ernerdl/smart-knob/docs/tartisma.md

# SmartKnob — sıkıntıların kökü üzerine tartışma

## Uzman A — açılış argümanı

### Tez

SmartKnob'un sorunlarının ezici çoğunluğu **fizikten veya bileşen sınırlarından değil, miras alınmış varsayılan değerlerden ve bayatlamış varsayımlardan** geliyor. Ve her seferinde ilk teşhis, en *ilginç* sebebi (EMI, döngü hızı, sürücü kalitesi, sensör gürültüsü) suçlayıp en *sıradan* olanı (bir vida, kimsenin dönüp bakmadığı bir sabit, yalan söyleyen bir yorum satırı) atladı.

### Kanıt — sadece bugünden

| belirti | ilk teşhis | ölçümle çıkan gerçek |
|---|---|---|
| HS 7 günde 824 MB | `sendLine` süreç açıyor | `brLevel()` 2 sn'de bir `ioreg` → günde 43.200 süreç × 2.4 KB ≈ **726 MB**. Asıl kaynak raporda hiç geçmiyordu |
| Aynı sızıntı | `mouseMoved` eventtap | Ölçüldü: 13.425 olay / 60 sn = **0.03 MB**. Masum |
| "Knob hangi taraftaysa oraya dayanıyor" | kalibrasyon / sürücü | `float maxA = 1.0f` — iskelet koddan kalma varsayılan |
| Konumlandırma 3.04° ıskalıyor | sürtünme 4–5 kat yüksek | `Kcenter = 6`, başka bir özellikten miras. 22 yapınca **0.09°** |
| Duvarlar esneyerek ölçülmüş olabilir | hipotez | Elle ölçüm: fark **0.1–0.2°**. Elendi |
| Çentik konumlandırmayla savaşıyor | benim teşhisim | Kod zaten `if/else` ile ayırıyormuş. **Yanlıştı** |

Tarihçede de aynı desen: "kesin EMI" → braket vidaları pedlere değiyormuş. "Sürücü kötü" → L298N'in kayıpları aslında sönüm sağlıyormuş. "Çentik zayıf, sertliği artır" → güç aralıktan geliyormuş, sertlik sadece kararsızlık üretiyormuş.

### Karşı tarafın muhtemel tezi ve ona cevabım

"Asıl sorun mimari: akım döngüsü yok, voltaj modu her şeyi sınırlıyor."

Kısmen doğru ama **öncelik sıralaması olarak yanlış.** Voltaj modu gerçek bir tavan koyuyor — sıfır hata matematiksel olarak imkânsız, her zaman `sürtünme ÷ sertlik` kadar ölü bölge kalıyor. Ama bugün ölçtük: o tavan **0.05°** civarında. Oysa sistem **3.04°** hata veriyordu. Yani gerçek sınır, yaşadığımız sorunun **altmışta biri**. Mimariyi suçlamak, 60 kat payı olan şeyi görmezden gelmek olur.

### Fiziğin gerçekten konuştuğu tek yer

Dürüst olmak için: sol duvarda integral **tavana dayanıyor** (2.5 V) ve 0.09–0.12°'de kalıyor. Orası gerçek bir sınır. Ama bu, ulaşılabilir hedeflerin %99'unu etkilemiyor.

### Pratik sonuç — açık sorunların zarar sıralaması

1. **EN pini 3.3V'a sabit.** Tek fiziksel hasar veren sorun: 2 gün motor sürülmüş, braket erimiş, LED'ler ölmüş. Bugün bootloader'da yine titredi. Bu **ölçüm disipliniyle çözülmez**, donanım işi. Ve listedeki tek "gerçek" sorun bu.
2. **Aralıklı adım sayımı arızası.** 2 vaka, sebep bilinmiyor, teşhis araçları hazır ama tekrarlamadı.
3. Uçtan uca test hiç yapılmadı.
4. Akım ölçümü (INA240 alındı, kurulmadı) — ölçüm aracı olarak değerli, ama yukarıdakilerin hiçbirini çözmez.

### Savunduğum ilke

Bu projenin en yüksek getirili aracı pahalı donanım değil, **evet/hayır cevabı zorlayan ucuz ölçüm** oldu. MT6701'in CRC sayacı bedava bir EMI dedektörü verdi (577M okuma, 0 hata — EMI tartışması tek komutla kapandı). Tam döngü hızındaki burst kaydedici teşhisi saatlerden saniyelere indirdi. Bugün duvar hipotezini 2 dakikalık elle ölçüm çürüttü.

Buna karşılık, ölçmeden yürütülen her teori yanlış çıktı — benimkiler dahil.

---

### (Dar konu: mutlak konumlandırma)

## Ortak zemin (ölçülen veriler)

Sistem: ESP32-S3 + SimpleFOC 2.3.3, GBM2805 (7 kutup çifti, faz-faz 5.51 Ω, 140 KV),
MT6701 14-bit SSI, L6234PD, 20 kHz PWM, **voltaj modu tork kontrolü (akım döngüsü YOK)**,
FOC ~7.7 kHz, `voltage_limit = 5 V`. Fiziksel aralık 319.6°, duvarlar 6.7° ve 326.3°.

Kontrolcü:
- Yol fazı (hata > 3°): `t = -6.0·e - 0.35·v`        (Kcenter = 6 V/rad)
- Tutma fazı (hata < 3° ve |v| < 1): `t = -22·e - 0.05·v - I`, `I += 100·e·dt`, |I| ≤ 1.5 V
- Varış: 0.05° içinde 50 ms. Zaman aşımı: 3 s (gidiş süresi dahil).

Ölçüm:

| hedef | devirdeki hata | integral | sonuç |
|---|---|---|---|
| 10° / 20° / 50° / 180° | 0.027–0.044° | 0.02–0.24 V | oturdu |
| 6.7° (sol duvar) | +0.133° | 0.90 V | zaman aşımı |
| 326.3° (sağ duvar) | −3.038° | 0.00 V | zaman aşımı |

Kısıtlar: akım ölçümü yok, osiloskop yok. `Kdet = 44` kararsızdı; sönüm artırmak çırpıntıyı
artırıyor (gecikmeli hız tahmini sönümü sertliğe çeviriyor).

---

## Uzman B — açılış argümanı (aynı anda yazıldı, A'nın açılışını görmeden)

### 1. Kök sebep: voltaj modunda takılma hatası = sürtünme ÷ sertlik

Akım döngüsü olmadığı için tork doğrudan komut edilen voltajdır. Knob, komut edilen voltaj
yerel sürtünmeyi yenemediği noktada durur. Denge şartı `K·e = V_sürtünme`, yani:

```
e_takılma = V_sürtünme / K
```

Sağ duvarda ölçülen: `6.0 × 0.05303 rad = 0.318 V` komutla durmuş. Yani oradaki sürtünme
≈ 0.32 V. Aynı sürtünme altında K = 22 olsaydı hata **0.83°** olurdu.

### 2. Asıl arıza bir kilitlenme, bir hassasiyet sorunu değil

Tutma fazının kapısı `|e| < 3.0°`, knob **3.038°**'de durmuş. İntegral (tek güçlü mekanizma)
kapının 0.038° dışında kaldığı için hiç devreye girmemiş. İntegrale ulaşmak için yaklaşmak,
yaklaşmak için integral gerekiyor.

Sol duvarda ise integral çalışmış ama hızı `100·e`, yani hata küçüldükçe yavaşlıyor:
0.133°'de **0.232 V/s**. 0.90 V'tan tavana (1.5 V) 2.6 s gerekiyordu, toplam bütçe 3 s ve
gidiş de buna dahil. Yani integral tavana dayanmadı, **süresi doldu**.

İki başarısızlık da kontrolcü yapısından geliyor; ikisi de fiziksel sınır değil.

### 3. Önerdiğim sıra

**(a) Önce homing esneklik testi (10 dk).** Duvar açıları `homingV = 4.5 V` ile bastırılarak
ölçüldü. `homingV = 1.5 V` ile yeniden homing yapılsın, iki ölçüm karşılaştırılsın. Fark
anlamlıysa duvar hedefleri **fiziksel olarak ulaşılamaz** demektir ve o iki vaka tartışma dışı
kalır. Bu test yapılmadan 1-2-3'e harcanan emek boşa gidebilir.

**(b) İki fazda aynı sertlik (K = 6 → 22), ama hız sınırıyla birlikte.**
Tek başına sertliği yükseltmek yetmez: 22 ile uzun yolda (176°) komut 5 V'a doyar, kararlı hız
`5/0.35 ≈ 14 rad/s` (800°/s) olur. Tutma fazına o hızla girildiğinde sönüm `0.05 × 14 = 0.7 V`,
yay ise `22 × 0.052 = 1.15 V` üretir → aşma ve salınım. Bu yüzden ya yol fazının sönümü 0.35'te
tutulmalı, ya da yaklaşmaya bir hız tavanı konmalı (ör. 3–4 rad/s).

**(c) İntegral: kapı mesafe değil hız olsun, ve bir taban hızı olsun.**
`|v| < 0.5 && |e| > POS_TOL` iken integre et; `posI += KI · max(|e|, e_taban) · sign(e) · dt`.
Küçük hatada sabit hızlı, büyük hatada orantılı. Sadece konumlandırma aktifken çalışsın
(kullanıcı knob'u tutarken birikip bırakınca fırlatmasın).

**(d) Kalıcı cevap: sürtünme ileri beslemesi.** Durur haldeyken komuta `sign(e)·V_kopma` ekle.
V_kopma, birkaç açıda yavaş voltaj rampasıyla ölçülür (burst kaydedici mevcut). Önemi:
**döngü kazancını artırmaz**, dolayısıyla `Kdet=44`'teki kararsızlığı geri getirmez.

### 4. Bundan bağımsız bir doğruluk hatası

```c
if (reached && absPos) { relAnchor = centerTarget; hapCenter = centerTarget; }
else relAnchor = motor.shaft_angle;     // zaman aşımında grid takılınan yere kayar
```
Konumlandırma mükemmel çalışsa bile, herhangi bir zaman aşımında "seviye ↔ açı" eşlemesi
sessizce bozulur. Konumlandırmayı düzeltmek bunu **gizler, çözmez**. Ayrıca düzeltilmeli.

### 5. Tartışmaya açtığım iddia

"Sertliği artırmak kararsızlık getirir" endişesinin bu bağlamda **geçersiz** olduğunu
savunuyorum. `Kdet = 44` ölçümündeki kararsızlığın kaynağı sertliğin kendisi değil, testere
profilinin sınırındaki **süreksizlikti**: sınırda tork `Kdet·sp` kadar (44 × 0.22 ≈ 9.7 V,
tavanın üstünde) sıçrıyor ve her sınır geçişi sisteme enerji enjekte ediyordu. Konumlandırma
yayı ise **tek kuyulu ve sürekli**; süreksizliği yok. Dolayısıyla K = 22'nin kararlı olduğu
zaten tutma fazında ölçülmüş durumda ve yol fazında da kararlı olmalıdır.

Karşı tarafın bu ayrımı çürütmesini ya da onaylamasını istiyorum: kararsızlığın kaynağı
süreksizlik mi, yoksa sertlik + hız tahmini gecikmesi mi?

### 6. Ayrışmayı bitirecek ölçülebilir tahminler

1. `homingV` 4.5 → 1.5 V: duvar açıları 1°'den fazla kayarsa → hipotez "duvar esnek" doğrulanır.
2. K = 22 ile orta bölgede takılma hatası ~0.06°, duvarda ~0.83° olmalı (sürtünme/sertlik).
3. Sürtünme ileri beslemesi eklenince hata, ileri besleme hatasının sertliğe bölümüne iner;
   V_kopma ±%20 doğrulukla ölçülürse hata < 0.2° olmalı.
4. K = 22 + mevcut sönüm (0.35) ile aşma olmamalı; sönüm 0.05'e indirilirse aşma görülmeli.

---

## Uzman B — 2. tur (A'nın açılışına cevap)

### Değerlendirme: nerede haklı

**Ölçüm disiplini tezi sağlam ve kanıtlı.** Altı vakanın altısında da "ilginç sebep" çürümüş.
Bu, tartışılacak bir şey değil, veri.

**Benim açılışımdaki iki maddeyi doğrudan çürüttü, kabul ediyorum:**

1. **Duvar esnekliği hipotezi.** Ben "önce bunu test edin, yoksa emek boşa gider" demiştim.
   A elle ölçmüş: fark **0.1–0.2°**. Hipotez eleniyor. Testin yapılması doğruydu, hipotezin
   ağırlığını fazla tahmin etmem yanlıştı.

2. **`e = V_sürtünme / K` modeliyle yaptığım tahmin yanlış çıktı.** K = 22 için **0.83°**
   öngörmüştüm, ölçülen **0.09°** — 9 kat sapma. Modelim neden şişti:
   - 0.318 V'u "oradaki sürtünme" saydım. Aslında o, **kilitlenmenin** ölçüsüydü: knob
     3.04°'de durdu çünkü yay zayıftı *ve* integral kapısı açılmadı. Sürtünmenin gerçek
     değeri bundan küçük, üst sınırını ölçmüştüm.
   - Statik denge modeli knob'un **hareket halinde** geldiğini yok sayıyor. Daha sert yayla
     gelen knob ölü bölgeyi kinetik enerjiyle geçiyor; denge noktası statik hesaptan dar.

   Bu, A'nın tezinin tam da örneği: ben de "fizik tavanı" diye sunduğum şeyi ölçmeden
   hesaplamıştım.

**Öncelik sıralaması da doğru.** EN pini listedeki tek **fiziksel hasar veren** sorun ve
yazılımla çözülemez. Birinci sırada olmalı.

### Nerede eksik: tezin kendi seçim yanlılığı

"Sorunların çoğu sıradan sebeplerden geliyor" iddiası **çözülmüş** vakalarla kanıtlanıyor.
Ama bir hata ancak sebebi bulunabildiğinde "çözülmüş" sayılıyor, ve ucuz ölçümle bulunabilen
sebepler tanımı gereği sıradan oluyor. Yani kanıt kümesi tezin lehine seçilmiş.

Testi şu: **açık kalan tek arıza** (aralıklı adım sayma, 2 vaka, tekrarlamıyor) bu yöntemin
yakalayamadığı sınıfta. Çünkü yöntem *tekrarlanabilir* belirtiye ihtiyaç duyuyor; bu arıza
tekrarlamıyor.

**Önerim — kara kutu:** Burst kaydedici zaten var ama elle tetikleniyor. Sürekli dönen bir
halka tampona çevrilsin (son ~2 sn: açı, hız, tork, adım olayları, HID gönderimleri, zaman
damgaları), ve **arıza imzası** tetiklesin (ör. adım tetiklendi ama HID gönderilmedi; ya da
iki adım arası < 20 ms). Arıza olduğunda otomatik dökülsün. Böylece tekrarlanamayan arıza
bir sonraki olduğunda **bir kez** yakalanır. Bu, A'nın ilkesinin doğal devamı: ucuz ölçümü
*olaydan sonra* değil, *olay anında* almak.

### Mimari tartışması: doğruluk değil, tekrarlanabilirlik

A, "voltaj modunun tavanı 0.05°, yaşadığımız hata 3.04° idi, yani mimari 60 kat önemsiz"
diyor. Bu **statik doğruluk** için doğru. Ama voltaj modunun asıl bedeli orada değil:

- **Sıcaklık.** Bakırın direnci ≈ **%0.39/°C** artar. Sargı 25°C ısınırsa faz direnci ~%10
  büyür → aynı voltaj komutu ~%10 daha az tork üretir. Voltaj modunda bunu gören kimse yok;
  akım döngüsü olsaydı otomatik telafi edilirdi.
- **Sonuç:** Soğuk başlangıçta kalibre edilen sertlik/sürtünme payları, 20 dakikalık
  kullanımdan sonra kayar. Bu, "kapı payı 2.1°, sürtünme biraz artsa ortada da kilitlenir"
  endişesinin somut mekanizmasıdır.
- **Akım sınırı yok.** Stall anında akımı sınırlayan tek şey `voltage_limit`. EN pini
  arızasında iki gün motor sürülmesinin braketi eritmesi bununla birleşiyor: korumasız
  sürücü + sınırsız akım.

Yani mimari, **bugünkü hatanın** sebebi değil — A haklı. Ama **yarınki tekrarlanabilirliğin**
ve termal güvenliğin sebebi. Bu yüzden INA240'ları "hiçbir şeyi çözmez" diye değil,
"sıcaklıkla kayma var mı" sorusunu kapatan ölçüm aracı olarak listede tutardım.

**Ölçülebilir tahmin:** Knob'u 10 dakika sabit bir hedefte tutup (sürekli tork), sonra aynı
test setini tekrarla. Gereken integral voltajı ve takılma hatası soğuk ölçüme göre **%5'ten
fazla** kayarsa, mimari "60 kat önemsiz" değil, zamanla sürüklenen bir hata kaynağıdır.
Kaymazsa tezini tamamen kabul ederim.

### Listeye eklediğim iki madde

**1. Grid sabitleme hatası** (A'nın listesinde yok):
```c
else relAnchor = motor.shaft_angle;   // zaman aşımında grid, knob'un takıldığı yere kayar
```
Konumlandırma artık 0.09°'de otursa bile, **herhangi bir** zaman aşımında "seviye ↔ açı"
eşlemesi sessizce bozuluyor. Bu bir doğruluk hatası; konumlandırmayı iyileştirmek onu
gizler, çözmez. Ucuz: varılamadığında da grid hedefe sabitlensin, hata loglansın.

**2. Kabul testi — ölçüm disiplinini altyapıya çevirmek.**
A'nın tezi doğruysa en yüksek getirili yatırım, bu disiplini kişisel alışkanlık olmaktan
çıkarıp tek komuta indirmek: 2 dakikalık otomatik öz-test (hedef taraması ve takılma hataları,
sürtünme tahmini, CRC hata sayacı, döngü frekansı, adım→HID gecikmesi) → sonuç dosyaya
yazılsın, **her değişiklikten sonra** çalıştırılıp bir öncekiyle kıyaslansın. Bugün bulunan
altı sebebin en az dördü böyle bir testin çıktısında kendiliğinden görünürdü.

### Birleşik öncelik önerim

1. **EN pini donanım düzeltmesi** (GPIO + 10k pull-down) — tek hasar veren sorun, A ile aynı
2. **Kara kutu kaydedici** — açık kalan tek arızanın yakalanabilmesi için tek yol
3. **Grid sabitleme hatası** — sessiz bozulma, 3 satır
4. **Kabul testi** — bundan sonraki her teşhisin maliyetini düşürür
5. **Termal kayma ölçümü** — mimari tartışmasını deneyle kapatır
6. INA240 — 5. maddenin cevabına göre karar

[SIRA: DIGERI]

---

## Uzman A — 2. tur (B'nin açılışına cevap)

### B nerede haklı

Üç noktada tamamen haklı ve ben bunları uyguladım:

- **Kilitlenme teşhisi.** `3.038°` değerinin `3.0°` kapısının dışında kalması — doğru, ve asıl arıza buydu.
- **İntegralin küçük hatada felç olması.** `100·e` formu matematiksel olarak kendini durduruyor.
- **`relAnchor` doğruluk hatası.** Bağımsız, gerçek, düzeltildi.

### B'nin bilmediği: önerileri uygulandı ve ölçüldü

B'nin açılışı eski veriyle yazılmış. Aradaki değişiklikler: yol fazı `K = 6 → 22` (sönüm 0.35'te
bırakıldı), integral tabanı `max(|e|, 0.5°)`, tavan `1.5 → 2.5 V`, ek takılma kapısı
(`|v| < 0.3` ve 400 ms), grid her durumda hedefe sabitleniyor.

İki bağımsız tur, çentik kapalı (`m free`):

| hedef | önce | tur 1 | tur 2 |
|---|---|---|---|
| 10° | — | −0.002° | +0.020° |
| 20° | — | +0.039° | −0.005° |
| 50° | — | +0.032° | −0.034° |
| 180° | — | −0.022° | −0.044° |
| 6.7° | +0.133° (zaman aşımı) | **+0.046°** | **+0.046°** |
| 326.3° | **−3.038°** (zaman aşımı) | **−0.094°** | **−0.116°** |

Tekrarlanabilirlik 0.02–0.07°, sensör çözünürlüğü (0.022°) mertebesinde.

**B'nin tahminlerinin durumu:**

| # | tahmin | sonuç |
|---|---|---|
| 1 | `homingV` testi duvar esnekliğini gösterecek | **Gereksiz kaldı.** Daha iyisi yapıldı: motor kapalı, kullanıcı elle duvara dayadı. Homing 6.7/326.3 — elle 6.8/326.1–326.2. Fark **0.1–0.2°**. Hipotez elendi |
| 2 | K=22'de hata ~0.06° (orta), ~0.83° (duvar) | **Fazla kötümser.** Ölçülen 0.02–0.05° ve 0.09–0.12° |
| 4 | K=22 + sönüm 0.35 → aşma yok | **Doğrulandı.** Aşma, salınım yok |

Tahmin 2'nin sapması B'nin modelini düzeltiyor: `e = V_sürtünme / K` formülü **nihai hatayı
değil, yayın tek başına takıldığı noktayı** veriyor. O nokta artık tutma kapısının içinde kaldığı
için integral devralıyor ve kalanı kapatıyor. Yani formül bir **giriş şartı**, sonuç değil.

### Küçük düzeltme

Ortak zemindeki etiketler ters: **6.7° kullanıcının SAĞI**, 326.3° solu. `knobDir = -1`, sensör
yönü kullanıcıya göre ters. Benim ilk problem tanımımda da yanlıştı, elle ölçümde ortaya çıktı.

### B'nin 5. maddesine cevap — kısmen katılmıyorum

> Kararsızlığın kaynağı sertlik değil, testere profilinin sınırındaki süreksizlikti.

**Ayrım gerçek ve değerli, ama iddia fazla güçlü.** İki ayrı mekanizma belgelenmiş durumda:

1. **Süreksizlik.** Ölçüm: sönüm 0.35'te 474 ms'de **91 sınır geçişi**, salınım 47 Hz'e
   kilitlenip tork tavanına dayanıyor. Merkez histerezisi tam da bunun için eklendi. B haklı.
2. **Gecikmeli hız — süreksizlikten bağımsız.** Sönüm taraması: 0.15→2, 0.35→14, 0.55→47.
   Sebep: `−B·v(t−τ)` iki parçaya ayrılıyor, `−B·cos φ·v` (gerçek sönüm, küçülüyor) ve
   `−B·ω·sin φ·x` (**sertlik**, büyüyor). Bu, sürekli bir yayda da olur.

Örneklenmiş veri pasiflik sınırı da sertlikle ölçekleniyor: `b > K·T/2 + B`. Bizim sayılarla
`Kt/R = 0.0143 N·m/V` üzerinden K=22 → 0.315 N·m/rad, T=130 µs → `K·T/2 = 2.0×10⁻⁵ N·m·s/rad`.
Gimbal motorun fiziksel sönümü de aynı mertebede. Yani K=22 **sınırda geçiyor**, bedava değil.
K=44'te şart iki katına çıkıyor.

**Uzlaşma önerim:** süreksizlik ek ve bizim vakamızda baskın bir enerji kaynağı; bu yüzden sürekli
bir yay testere profilinden **daha yüksek** K'ya dayanır. Ama sınırsız değil — pasiflik şartı
süreksizlikten bağımsız olarak K ile ölçekleniyor.

**Ayrışmayı bitirecek test:** konumlandırma yayının K'sını kademeli yükselt (22 → 44 → 88),
burst kaydıyla her birinde varışa bak. Testere profilinde kararsız olan 44'te sürekli yay kararlı
kalırsa B'nin ayrımı doğrulanır. Bir yerde kararsızlık çıkarsa sertlik terimi de gerçektir.
Bu test bende, yapabilirim.

**Bir uyarı:** mevcut K=22 kararlılık sonucu `useObs = true` ile, yani PLL gözlemleyicisiyle
alındı — ham LPF ile değil. Gözlemleyicinin faz gecikmesi farklı. Karşılaştırma yapılacaksa
hız kaynağı sabit tutulmalı.

### Kendi hatam

Bu turda bir teşhisim çürüdü: "çentik konumlandırmayla savaşıyor, 2.42 V'a karşı 0.31 V" dedim.
Koda bakınca çentik ile konumlandırmanın zaten `if/else` ile ayrıldığı görüldü. Beni yanıltan,
elle bırakınca knob'un durduğu açı (323.7°) ile konumlandırmanın takıldığı açının (323.3°)
yakınlığıydı — tesadüf. Bu, açılış tezimin kendi üzerimde de doğrulanması: ölçmeden yürütülen
teori yanlış çıkıyor.

### Açık kalanlar

- **Sürtünme ileri beslemesi (B'nin d maddesi):** hâlâ yapılmadı, ama tipik hata 0.02–0.05°'ye
  indiği için aciliyeti kalmadı. Sadece sol duvarda integral tavana dayanıyor (2.5 V).
- **Mimari tez:** B'nin de dolaylı savunduğu "akım döngüsü yokluğu kök sebep" görüşüne
  itirazım duruyor — voltaj modunun koyduğu gerçek tavan ~0.05°, yaşadığımız hata 3.04°'ydi.
  Pay 60 kat. Mimari bir tavan koyuyor ama sorunumuz o tavanda değildi.
- **Listedeki tek fiziksel sorun:** EN pini 3.3V'a sabit. Bugün bootloader'da motor yine titredi.
  Bu tartışmanın konusu olan hiçbir kontrol inceliği onu çözmüyor.

[SIRA: DIGERI]

---

## Uzman B — 3. tur

### Kabul ettiklerim

- **Tahmin 2 çürüdü, hem de benim lehime olmayan yönde.** 0.83° öngördüm, ölçüm 0.09–0.12°.
  A'nın yeniden yorumu benimkinden keskin: `e = V_sürtünme / K` **nihai hata değil, yayın tek
  başına takıldığı nokta**, yani tutma fazının *giriş şartı*. Formülün doğru kullanımı bu.
  Düzeltmeyi alıyorum.
- **Tahmin 1 (homing testi) gereksizdi.** Motor kapalı + elle dayama daha iyi bir deney.
- **Etiket düzeltmesi** (6.7° kullanıcının sağı) kabul.
- **İki mekanizma ayrımı** (süreksizlik + gecikmeli hız) doğru; benim 5. maddem tek mekanizmaya
  indirgediği için fazla güçlüydü.

### Ama pasiflik hesabında bir terim eksik

A, örneklenmiş veri pasiflik şartını `b > K·T/2 + B` olarak kurup "K=22 sınırda geçiyor"
diyor. Sayılar doğru: `Kt/R = 0.0394/2.75 = 0.0143 N·m/V`, `K = 22 V/rad → 0.315 N·m/rad`,
`T = 130 µs` → `K·T/2 = 2.05×10⁻⁵ N·m·s/rad`.

Eksik olan, sol taraftaki `b`'nin ne olduğu. **Voltaj modunda baskın sönüm mekanik değil,
elektriksel:** geri-EMK, hıza orantılı bir karşı tork üretir.

```
b_elektriksel = Ke · Kt / R = 0.0394 × 0.0143 = 5.6 × 10⁻⁴ N·m·s/rad
```

Bu, `K·T/2`'nin **27 katı**. Yani:

| K (V/rad) | K·T/2 | b_elektriksel | pay |
|---|---|---|---|
| 22 | 2.0×10⁻⁵ | 5.6×10⁻⁴ | **27×** |
| 44 | 4.1×10⁻⁵ | 5.6×10⁻⁴ | 14× |
| 88 | 8.2×10⁻⁵ | 5.6×10⁻⁴ | 7× |
| ~600 | 5.6×10⁻⁴ | 5.6×10⁻⁴ | **1× (gerçek sınır)** |

Dolayısıyla **K=22 sınırda değil, sınırın 27 katı altında.** Örneklenmiş veri pasifliği
`Kdet=44`'teki kararsızlığı açıklayamaz. Bu, benim ayrımımı tamamen değil ama kuvvetle
destekliyor: K=44'te patlayan şey pasiflik değildi.

Bu hesabın bir yan sonucu var ve önemli: **`estMode` bu 5.6×10⁻⁴'ü iptal ediyor.** KV ileri
beslemesi geri-EMK'yı telafi ettiği için elektriksel sönüm de siliniyor. Yani est modunda
pasiflik payı 27 kattan ~1 kata düşer. Kodundaki "riskli" sezgisinin sayısal karşılığı bu.
Est modu açılırsa kararlı K tavanı dramatik düşer.

### Geriye kalan mekanizma: gecikmeli hız, ve K'ya bağımlılığı dolaylı

A'nın 2. mekanizması gerçek. Ama K ile ilişkisi doğrudan değil, **salınım frekansı üzerinden**:

- Atalet: ölçülen 47 Hz salınım ve K=0.315 N·m/rad ile `J = K/ω² = 0.315/(2π·47)² ≈ 3.6×10⁻⁶ kg·m²`
- `ω ∝ √(K/J)` → K dört katına çıkınca frekans iki katına
- Gecikme sabit olduğu için **frekans arttıkça faz kayması artar**: LPF `Tf=0.01` ile 47 Hz'de
  `atan(2π·47×0.01) = 71°` — sönüm teriminin büyük kısmı sertliğe dönüşüyor
- PLL gözlemleyici (bw=800) aynı frekansta çok daha az kayma veriyor

Yani kararsızlığı belirleyen çarpan **B · sin φ(ω)**. B küçükken (0.05) bu terim küçük kalıyor;
A'nın sönüm taraması (0.15→2, 0.35→14, 0.55→47 çırpıntı) tam olarak bunu gösteriyor — **sabiti
değişen K değil, B idi.**

### Ayrışmayı bitirecek testin düzeltilmiş hali

A'nın önerdiği K taraması doğru ama tek boyutlu; iki sebebi ayıramaz. İki boyutlu olmalı:

| | B = 0.05 | B = 0.35 |
|---|---|---|
| K = 22 | temel | ? |
| K = 44 | ? | ? |
| K = 88 | ? | ? |

**Benim tahminim:** B = 0.05 sütununda K = 88'e kadar kararlı kalır (pasiflik payı 7×).
B = 0.35 sütununda K büyüdükçe kararsızlık erken çıkar. Böyle çıkarsa sorumlu **sertlik değil,
sönüm × gecikme**. Her iki sütunda da aynı K'da patlarsa A haklı, sertlik terimi gerçektir.

A'nın `useObs` uyarısı yerinde ve bunu genişletiyorum: tarama **hem gözlemleyici hem ham LPF**
ile tekrarlanmalı. LPF'de kararsızlık belirgin şekilde daha erken çıkmazsa, gecikme mekanizması
hakkındaki ortak varsayımımız yanlış demektir.

### Mimari tartışmasında duruşum

A'nın "pay 60 kat" argümanını **statik doğruluk için kabul ediyorum** ve mimariyi kök sebep
olarak savunmuyorum. İtirazım dar: voltaj modunun bedeli doğrulukta değil, **zamanla
sürüklenmede** (bakır %0.39/°C → 25°C'de ~%10 tork kaybı) ve **akım sınırının olmamasında**.
İkincisi EN pini vakasıyla doğrudan birleşiyor: korumasız sürücü + sınırsız akım = eriyen braket.

Termal deney teklifim duruyor ve artık daha ucuz: test seti zaten otomatikleşmiş durumda.
10 dakika sürekli tutma sonrası aynı seti çalıştır; takılma hatası ve gereken integral voltajı
%5'ten az kayarsa itirazımı geri çekerim.

### Öncelik: tek cümlede ortaklaştık

EN pini. İkimiz de listenin başına koyduk, ikimiz de "bu tartışmanın konusu olan hiçbir kontrol
inceliği onu çözmüyor" diyoruz. Kalan tartışma (K taraması, termal, sürtünme ileri beslemesi)
o yapılmadan **sahada** değil sadece masada geçerli.

[SIRA: DIGERI]

---

## Uzman A — 4. tur

### İtirazımı geri çekiyorum

B'nin elektriksel sönüm terimi doğru ve benim pasiflik itirazımı geçersiz kılıyor. Bağımsız
doğruladım: voltaj modunda `I = (Uq − Ke·ω)/R`, dolayısıyla

```
τ = (Kt/R)·Uq − (Kt·Ke/R)·ω
                 └──────────┘  hıza orantılı KARŞI tork = sönüm
b_el = Kt·Ke/R = 0.0394²/2.75 = 5.6×10⁻⁴ N·m·s/rad
```

Ben `b`'yi mekanik sönümle (≈0) özdeşleştirmiştim. Yanlıştı: motorun kendisi bir sönümleyici.
K=22'de pay 27 kat, K=44'te 14 kat. **Örneklenmiş veri pasifliği `Kdet=44`'ü açıklamıyor.**

Bu, araştırma raporlarının merkezi iddiasını da çürütüyor — *"sizin sisteminizde fiziksel sönüm
b ≈ 0, Colgate–Schenkel açıkça ihlal ediliyor"*. O öncül yanlışmış.

İroni: formül **firmware'in kendi yorumunda zaten yazılı** (satır 258, `(Kt/R)(Uq − Ke·ω)`).
İkinci terimin sönüm olduğunu kimse fark etmemiş.

### B'nin görmediği sonuç: README'deki L298N açıklaması da çürüyor

`b_el = Kt·Ke/R` **R ile ters orantılı.** Sürücünün direnci toplam R'ye ekleniyor:

| sürücü | ek direnç | toplam R | b_el |
|---|---|---|---|
| L298N (Darlington, ~2 V düşüm @1A) | ~2 Ω | ~4.75 Ω | 3.3×10⁻⁴ |
| L6234PD (0.3 Ω/anahtar × 2) | 0.6 Ω | ~3.35 Ω | **4.6×10⁻⁴** |

Yani L6234 **%40 daha fazla** elektriksel sönüm veriyor. Buna rağmen ona geçince çırpıntı çıktı.

README şöyle diyor:

> L298N ile de çalışıyordu — ve kısmen kötü olduğu için. Kayıpları ve yavaşlığı... yumuşatıyordu.

**Mekanizma olarak bu yanlış.** L298N'in kayıpları sönümü azaltıyordu, artırmıyordu. Gerçek sebep
büyük ihtimalle **ölü bölge**: Darlington'un ~2 V düşümü ve geniş ölü zamanı, küçük komutları
çıkışa hiç geçirmiyordu. Küçük genlikli limit çevrimleri bu yüzden doğamıyordu. Bu sönüm değil,
bir eşik — enerji yutmuyor, sadece küçük sinyali öldürüyor.

Ayrım pratik: ölü bölge çırpıntıyı gizler ama hassas konumlandırmayı da öldürür. Bugün
ölçtüğümüz 0.02–0.05°, L298N'de mümkün olmazdı.

### 2 boyutlu tarama yerine daha ucuz ve daha keskin bir test

B'nin K×B matrisi doğru kurgu ama 6+ koşu gerektiriyor. Daha doğrudan bir yol var ve B kendisi
işaret etti: **`estMode`, `b_el`'i iptal ediyor.**

KV ileri beslemesi `Ke·ω`'yı telafi ediyorsa, geri-EMK'nın ürettiği karşı tork da siliniyor.
Yani est modu, pasiflik payını 27 kattan ~1 kata indiren tek anahtar — ve kodda `E` komutuyla
hazır duruyor.

**Test:** aynı K'da est modu aç/kapa, burst kaydıyla varışa bak.
- Est açıkken belirgin kararsızlık çıkarsa → `b_el` baskın sönüm, B'nin tezi doğrulanır
- Fark çıkmazsa → `b_el` hesabı pratikte geçerli değil, matrise dönülür

Tek uyarı: est modunda komut `lastT/phaseR` ile ölçekleniyor, yani tork skalası birebir aynı
değil. Karşılaştırma öncesi eşitlenmeli.

Bu test ayrıca kodda duran bir sezgiyi de sayısallaştırıyor: `estMode = false // KAPALI (kararli
ayar bunsuz bulundu)`. Neden kararlı ayarın bunsuz bulunduğunun cevabı muhtemelen bu.

### Kabul ettiklerim

- K×B matrisi, est testinden sonra hâlâ gerekirse yapılsın; tasarımı doğru
- Hem gözlemleyici hem ham LPF ile tekrar — kabul
- Termal deney: kabul, kriteri de (%5) kabul ediyorum
- Mimari konusunda ayrışmamız kalmadı: statik doğrulukta pay bizde değil mimaride değil;
  sürüklenme ve akım sınırı itirazları geçerli

### Kalan tek ayrışma yok gibi

B'nin 5. maddesindeki asıl iddiayı (`Kdet=44` kararsızlığı sertlikten değil süreksizlikten)
artık **destekliyorum**, çünkü pasiflik itirazım düştü ve geriye kalan iki mekanizma da
(süreksizlik, `B·sin φ`) sertlikten bağımsız. Sürekli yayda K=22'nin kararlı çıkması da bunu
doğruluyor.

### Ortak sonuç

EN pini. İkimiz de aynı yere vardık ve bu tartışmanın hiçbir çıktısı onu çözmüyor.

[SIRA: DIGERI]

---

## Uzman B — 5. tur

> **Ortak kural önerisi (kullanıcıdan geldi):** Bundan sonra her iddia ya **kaynaklı** olsun
> (kod satırı, datasheet, makale, ölçüm) ya da açıkça **"hafızadan, doğrulanmadı"** diye
> işaretlensin. Bu turda kendi önceki iddialarımı da bu kurala göre denetledim.

### Önce kendi kaynaklandırmam

**1. Colgate–Schenkel şartı (`b > KT/2 + B`) — kısmen doğrulandı.**
Birincil makale ücretli duvar arkasında ([Wiley](https://onlinelibrary.wiley.com/doi/abs/10.1002/(SICI)1097-4563(199701)14:1%3C37::AID-ROB4%3E3.0.CO;2-V)),
Stanford'daki Weir–Colgate derlemesinin linki 404 verdi. Formu bu haliyle aktaran iki derleme
buldum: [arXiv 2008.06685](https://arxiv.org/pdf/2008.06685) ve [arXiv 2008.11099](https://arxiv.org/pdf/2008.11099)
— ikisi de `b`'yi "arayüzün kendi sönümü", `K`/`B`'yi sanal duvarın sertliği/sönümü, `T`'yi
örnekleme periyodu olarak tanımlıyor. Erişilebilir birincil kaynak: [Colgate & Brown, ICRA 1994](https://cim.mcgill.ca/~hayward/Teach/papers/Part-II/Colgate-Brown-94.pdf)
(B ≥ 0 ve B < 0 durumlarını ayrı ele alıyor). **Doğrulanmadı:** eşitsizliğin tam/kesin formu
birincil kaynaktan okunmadı. Sayısal sonucumuz (27–80 kat pay) bu ayrıntıya duyarlı değil.

**2. Atalet tahminim zayıf, işaretliyorum.** `J = K/ω²` ile 47 Hz'den 3.6×10⁻⁶ kg·m² çıkardım.
Ama rotor + knob için kaba geometrik tahmin (~30 g, r≈20 mm) **~1×10⁻⁵** veriyor, yani 3 kat fark.
Muhtemel açıklama: 47 Hz **doğal frekans değil, bir limit çevrimiydi** (testere profilinin sınır
geçiş frekansı). `ω ∝ √(K/J)` argümanım niteliksel olarak ayakta ama sayısı güvenilmez.

### A'nın L298N düzeltmesi: yönü doğru, modeli eksik — ve düzeltince iddiası güçleniyor

A, L298N'i ~2 Ω seri direnç olarak modelledi. Darlington çıkış katı **direnç gibi değil, sabit
voltaj düşümü** gibi davranır. ST datasheetine göre ([L298, DS0218](https://www.st.com/resource/en/datasheet/l298.pdf)):
toplam V_CEsat **1.8 V (tip) / 3.2 V (maks) @ 1 A**, ayrışmış hali ~0.95 V kaynak + 0.85 V çeken.

Sonuç:

| akım | L298N düşümü | etkin seri empedans | b_el (R_toplam ile) |
|---|---|---|---|
| 1.0 A | ~1.8 V | ~1.8 Ω | 3.4×10⁻⁴ |
| **0.3 A** (knob'un tipik bölgesi) | ~1.6 V | **~5.3 Ω** | **1.9×10⁻⁴** |
| L6234 (0.3 Ω × 2) | — | 0.6 Ω | 4.6×10⁻⁴ |

Yani düşük akımda fark A'nın hesapladığı %40 değil, **2–2.5 kat**. A'nın sonucu (L6234 daha
fazla elektriksel sönüm veriyor, README'nin mekanizma açıklaması yanlış) **daha da güçleniyor**.

Ve "ölü bölge" iddiası artık sadece hipotez değil, **datasheetten sayıyla çıkıyor**: sabit
~1.8 V düşüm demek, `voltage_limit = 5 V` ölçeğinde komutun **ilk %36'sı çıkışa hiç ulaşmıyor**
demek. Küçük genlikli limit çevrimi doğamaz çünkü küçük komut fiziksel olarak yok sayılıyor.
A'nın ayrımına (sönüm değil, eşik) katılıyorum.

### Est-modu testine itiraz: kaynağından bakınca temiz değil

A'nın testi zekice ama bir varsayıma dayanıyor: "KV ileri beslemesi `Ke·ω`'yı telafi eder."
Kütüphane kaynağında ([`.pio/libdeps/.../BLDCMotor.cpp`](firmware/.pio/libdeps), 2.3.3, satır 398–408):

```c
if (_isset(KV_rating)) voltage_bemf = shaft_velocity/KV_rating/_RPM_TO_RADS;
...
else voltage.q = target*phase_resistance + voltage_bemf;
```

ve yapıcıda (satır 45–49): `KV_rating = _KV * _SQRT2;` ("rms value").

**Bizim firmware KV'yi yapıcıdan değil, doğrudan atıyor** (`motor.KV_rating = motorKV;`), yani
√2 çarpanı yok. Telafi sabiti böylece `1/(140·0.10472) = 0.0682 V·s/rad` oluyor. Oysa
`foc_haptic.cpp` yorumunda varsayılan değer `1/(KV·√3·RPM_TO_RADS) = 0.0394`. Üç aday:

| yol | telafi sabiti |
|---|---|
| kodun fiilen kullandığı | 0.0682 |
| kütüphanenin yapıcı yolu (×√2) | 0.0482 |
| yorumun varsaydığı (×√3) | 0.0394 |

Fark 1.73 kat. **Telafi gerçek Ke'den büyükse net sönüm negatif olur** — yani est modu açınca
çıkan kararsızlık, `b_el`'in iptalini değil, **aşırı telafiyi** gösterebilir. Test, sonucu
iki farklı sebeple aynı görünen bir deney haline geliyor.

Ayrıca kodda zaten **ters yönde bir ölçüm** duruyor:
`"305 derece uctan uca savurma -> 238ms'de TAM durdu ... Est kapaliyken cok daha az enerjiyle
hic durmuyordu"` (satır ~257). Est modu sönümü **artırmış** görünüyor. Bu, basit "est, `b_el`'i
siler" hikayesiyle çelişiyor ve ölçeklendirme farkının (komut `/phaseR`) baskın olabileceğini
düşündürüyor.

### Ke'den bağımsız, iki koşuluk ve daha keskin bir deney

`b_el`'i doğrudan ölçmek için ne Ke'yi ne de est modunu bilmeye gerek var:

**Serbest salınım sönme testi — sürücü AÇIK vs KAPALI.**

- **A koşusu:** FOC açık, `m free` (tork komutu 0). Komut 0 olsa bile inverter q voltajını 0'da
  **tutuyor**, yani sargılar kısa devre gibi davranıyor → geri-EMK akım sürüyor → `b_el` aktif.
- **B koşusu:** `motor.disable()` (veya EN düşük) → uçlar açık devre → `b_el = 0`, sadece mekanik
  sürtünme kalır.
- Her iki koşuda knob'u elle savur, burst kaydediciyle hızı kaydet, sönme sabitini çıkar.

**Niceliksel tahminim:** serbest modda hız için `τ_sönme = J/b_el`. `b_el = 5.6×10⁻⁴` ve
J = 1×10⁻⁵ (geometrik tahmin) ile **~18 ms**; J = 3.6×10⁻⁶ ile ~6 ms. Yani **sürücü açıkken knob
savurulduğunda neredeyse anında durmalı; kapalıyken belirgin şekilde salınmaya devam etmeli.**
Fark bu kadar büyükse elle bile görülür, burst kaydı sayıyı verir.

Bu deneyin üç üstünlüğü var:
1. Ke konvansiyonundan bağımsız — ölçülen doğrudan `b_el`
2. Est modunun ölçek sorununa girmiyor
3. Aynı kayıttan **J** de çıkıyor (bilinen K ile salınım frekansından), böylece benim 3 kat
   belirsiz atalet tahminim kapanıyor

Fark çıkmazsa `b_el` hesabı (ikimizin de dayandığı) pratikte geçersiz demektir ve pasiflik
tartışması yeniden açılır.

### Sırada

1. Sönme testi (2 koşu) → `b_el` ve J ölçülür
2. Gerekirse K×B matrisi, hız kaynağı sabit tutularak
3. Termal deney (%5 kriteri)
4. Ve hepsinden önce: **EN pini.** İkimiz de aynı yerdeyiz.

[SIRA: DIGERI]

---

## Uzman A — 6. tur

### Kabul

**L298N modeli.** Darlington'un sabit düşüm olarak modellenmesi doğru, benim ~2 Ω seri direnç
yaklaşımım kabaydı. Düşük akımda fark %40 değil 2–2.5 kat — sonucum güçleniyor, düzeltmeyi alıyorum.

**Est-modu itirazı geçerli.** Kodda doğruladım (`foc_haptic.cpp:933`, `:1296`):
`motor.KV_rating = motorKV;` — doğrudan atama, kütüphanenin yapıcısındaki `_KV * _SQRT2` yolu
atlanıyor. B'nin işaret ettiği 1.73 katlık belirsizlik gerçek. Test iki sebebi ayıramıyor.

### Ama B'nin karşı kanıtı geçersiz bir ölçüme dayanıyor

B, est modunun sönümü *artırdığına* dair kodda duran şu notu gösterdi (`foc_haptic.cpp:269`):

> `Olculdu: 305 derece uctan uca savurma -> 238ms'de TAM durdu (son 80ms hiz std = 0.000)`

**Bu ölçüm bu projede zaten geçersiz ilan edilmişti.** Knob 238 ms'de sönümlendiği için durmadı,
**fiziksel duvara çarptığı için** durdu — 305°, toplam aralığın (319.6°) neredeyse tamamı.
"Son 80 ms hız std = 0.000" ifadesi de sönmeyi değil, duvara dayanmış olmayı anlatıyor.

Yorum satırı düzeltilmeden kodda kalmış. Yani B, çürütülmüş bir ölçümü kaynak göstermiş —
kaynak kuralının tam da uyardığı durum, sadece kaynak kod olduğu için güvenilir görünüyor.

Sonuç: est modunun sönümü artırdığına dair **elimizde kanıt yok**. B'nin itirazı testi geçersiz
kılıyor ama kendi karşı iddiasını desteklemiyor. İkisi de açık kalıyor.

### Sönme testine katılıyorum — ama B koşusu bu donanımda YAPILAMAZ

Deneyin kurgusu doğru. Sorun uygulamada:

**`motor.disable()` sargıları açmaz.** Sürücü enable pini bir GPIO'ya bağlı olmadığı için
SimpleFOC'un `disable()`'ı yalnızca PWM'i sıfırlar. 3PWM'de üç faz da %0 duty → üçü de GND'ye
bağlı → **eşit potansiyel → hâlâ kısa devre → `b_el` hâlâ aktif.**

Aynı şey `v 0` için de geçerli: `Uq = Ud = 0` → `setPhaseVoltage` üç faza da `V/2` verir →
üçü eşit → kısa devre.

**Bunun bir sonucu var ve geriye dönük:** bu projedeki her "serbest" ölçüm `b_el` aktifken
yapılmış. Bugün duvarları elle ölçerken `m free` + `v 0` kullandık — kullanıcının hissettiği
direnç saf mekanik sürtünme değildi, sargı kısa devresinin frenlemesiydi. Ölçtüğümüz duvar
açıları etkilenmez (statik), ama "sürtünme ≈ 0.32 V" gibi dinamik çıkarımlarımız etkilenir.

**Tek açma yolu 12V'u kesmek.** VS yokken FET'ler sürülemez, geriye gövde diyotları kalır;
geri-EMK iki diyot düşümünü (~1.4 V) aşana kadar akım geçmez. `Ke = 0.0394` ile bu
**ω > 35 rad/s** demek. Bizim savurma hızlarımız (~7–14 rad/s) bunun altında, yani 12V kapalıyken
devre pratikte açık. Deney bu haliyle yapılabilir:

| koşu | 12V | sargı | `b_el` |
|---|---|---|---|
| A | açık, FOC çalışıyor, tork 0 | kısa | aktif |
| B | **kesik** | açık (ω < 35 rad/s) | ~0 |

İkisinde de knob'u savur, burst kaydıyla hızı al, sönme sabitini çıkar. B'nin `τ = J/b_el`
tahmini (6–18 ms) doğruysa A koşusunda knob neredeyse anında durur, B'de salınmaya devam eder —
fark elle bile hissedilir, kayıt sayıyı verir. Aynı kayıttan J de çıkar.

**Bir uyarı:** burst kaydedici 12V kesikken de çalışır (ESP USB'den besleniyor, sensör de), yani
B koşusunda veri toplamak sorun değil.

### Nereye vardığımız

Deneyi mümkün kılmak için 12V'u elle kesip vermek gerekiyor — çünkü EN pini 3.3V'a sabit ve
yazılımdan köprüyü açamıyoruz. **Tartışmanın son teknik adımını engelleyen donanım kısıtı,
iki gün motor sürüp braketi eriten kısıtın aynısı.** Üçüncü turdan beri ikimizin de listenin
başına koyduğu madde, şimdi deneyin önkoşulu olarak da karşımıza çıktı.

### Düzeltilecek kayıt

`foc_haptic.cpp:269`'daki geçersiz ölçüm yorumu hâlâ duruyor ve bu turda birini yanılttı.
Düzeltilmesi gerekiyor — projenin "eski şeyler neden kalıyor" sorununun bir örneği daha.

[SIRA: DIGERI]

---

## Uzman B — 7. tur

### Kabul: 238 ms ölçümünü yanlış kullandım

A haklı. 305°, toplam aralığın (319.6°) %95'i; "son 80 ms hız std = 0.000" sönmeyi değil duvara
dayanmayı anlatıyor. Kaynak göstermem onu geçerli yapmadı — **kaynak kuralının zayıf noktası
tam da bu**: kod yorumu "birincil kaynak" gibi görünüyor ama doğrulanmamış bir ölçümün kaydı
olabiliyor. Kuralı güncelliyorum: *kaynak + o kaynağın nasıl üretildiği.*

Yorumun kendi içinde de çelişkisi var (`foc_haptic.cpp:259-270`): aynı blok hem "est modu
`b_elek`'i iptal eder, RİSKLİ" diyor hem de est modunun daha iyi söndürdüğünü iddia ediyor.
İkisi aynı anda doğru olamaz. Yorumun tamamı şüpheli, silinmeli.

### A'nın `disable()` tespitini kaynağından doğruladım

`.pio/libdeps/foc/Simple FOC/src/drivers/BLDCDriver3PWM.cpp:32-41`:

```c
void BLDCDriver3PWM::disable() {
  setPwm(0, 0, 0);
  if ( _isset(enableA_pin) ) digitalWrite(enableA_pin, !enable_active_high);
  ...
}
```

Bizim kodda enable pinleri **tanımlı değil** (3.3V'a sabit). Dolayısıyla `disable()` = üç fazın
duty'si %0 = üçü de alt FET üzerinden GND'de = **kısa devre.** A'nın tespiti doğru, deneyin B
koşusu bu haliyle yapılamaz.

### Daha basit bir açık devre: iki fazı sökmek

12V kesme + gövde diyodu eşiği (`ω > 1.4/Ke`) **Ke belirsizliğine bağlı**: Ke = 0.0394 ise eşik
35 rad/s, Ke = 0.0682 ise **20.5 rad/s**. Savurma hızlarımız bu bandın içine girebilir, yani
B koşusu kendi belirsizliğimizi deneyin içine taşıyor.

Doğrudan çözüm: **iki motor fazını sök.** Tek faz sökmek yetmez — kalan iki faz hâlâ inverterin
alt FET'leri üzerinden kısa devre kalır ve frenlemeyi kısmen sürdürür. İkisi sökülünce akım
yolu yok, diyot eşiği tartışması da ortadan kalkar. Klemensli bağlantıda 30 saniyelik iş.

### Ama ikimizin de atladığı daha verimli bir deney var

`b_el` tartışmasının altında yatan asıl bilinmeyen **Ke'nin kendisi** (1.73 kat belirsizlik).
Onu ölçersek `b_el = Ke²/R` hesapla çıkar, deneye bile gerek kalmaz. Üstelik aynı koşuda
sürtünme de ölçülür:

**Sabit voltaj basamağı taraması.**
1. Knob'u bir duvara yasla, `m free`
2. Sabit `Uq` ver (0.3 / 0.5 / 0.8 / 1.2 V), diğer duvara varmadan burst kaydıyla **kararlı
   hızı** oku
3. `ω` ile `Uq`'yu çiz

Voltaj modunda kararlı durumda `Uq = Ke·ω + V_sürtünme`, yani:
- **eğim = Ke** → 0.0394 mü 0.0682 mi, konvansiyon tartışması biter
- **kesişim = V_sürtünme** → 1. turdan beri tartıştığımız sayı doğrudan ölçülür
- `b_el = Ke²/R` buradan hesaplanır

Zamanlama tutuyor: elektriksel sönme sabiti `J/b_el ≈ 6–18 ms`, yani kararlı hıza ~50 ms'de
varılır; 5.6 rad'lık yol ω = 15 rad/s'de 370 ms sürer. Ölçüm penceresi rahat.

Bu deney 12V kesmeyi, faz sökmeyi ve est modunu **hiç gerektirmiyor**, mevcut firmware ve burst
kaydediciyle bugün yapılabilir. Sönme testi bundan sonra bir **doğrulama** olur, keşif değil.

### Bir düzeltme: statik sürtünme çıkarımımız kirlenmedi

A, "bu projedeki her serbest ölçüm `b_el` aktifken yapıldı, dinamik çıkarımlarımız etkilenir"
diyor. Doğru — ama `V_sürtünme ≈ 0.32 V` çıkarımı bundan **etkilenmez**, çünkü elektriksel sönüm
hıza orantılı (`b_el·ω`) ve takılma anında ω ≈ 0. Statik denge noktaları temiz; etkilenen şey
savurma/sönme gözlemleri ve "knob elde ne kadar ağır hissediyor" türü yargılar.

### EN pini: artık sadece güvenlik sorunu değil, deney kısıtı

A'nın vardığı yere katılıyorum ve bir adım ileri götürüyorum: EN'i bir GPIO'ya almak (10k
pull-down ile) üç şeyi aynı anda çözüyor:
1. İki gün motor süren arıza sınıfını kökten kapatıyor
2. Sönme testinin B koşusunu **yazılım komutuna** indiriyor (12V kesme ritüeli yok)
3. `disable()` gerçekten devre dışı bırakıyor — kütüphanenin zaten beklediği davranış

Yani tartışmanın kalan tüm teknik adımları aynı donanım düzeltmesinin arkasında bekliyor.

### Sıra önerim (güncellendi)

1. **EN pini → GPIO + 10k pull-down** (donanım, her şeyin önkoşulu)
2. **Voltaj basamağı taraması** → Ke ve V_sürtünme ölçülür, `b_el` hesaplanır
3. Sönme testi (artık yazılımla) → `b_el` ve J doğrulanır
4. Gerekirse K×B matrisi
5. `foc_haptic.cpp:259-270` yorumu silinsin — bu turda ikimizi de yanılttı

[SIRA: DIGERI]

---

## Uzman A — 8. tur

### Kabul: statik sürtünme çıkarımı hakkında fazla ileri gittim

B haklı. `b_el·ω` terimi takılma anında (ω ≈ 0) sıfır, dolayısıyla `V_sürtünme ≈ 0.32 V`
çıkarımı kirlenmedi. "Her serbest ölçüm etkilendi" demem aşırıydı — etkilenen sadece dinamik
gözlemler (savurma, sönme, elde ağırlık hissi). Düzeltmeyi alıyorum.

### Voltaj basamağı taraması: matematiği doğruladım

Kararlı durumda net tork sıfır:

```
(Kt/R)·(Uq − Ke·ω) = τ_sürtünme
Uq = Ke·ω + τ_sürtünme·R/Kt
     └┬─┘   └──────┬──────┘
    eğim        kesişim
```

Doğru. Ve konvansiyon tartışmasını da bitiriyor, çünkü ölçülen şey "firmware'in kendi
biriminde etkin Ke" — hangi kök-2'nin doğru olduğunu tartışmaya gerek kalmıyor.

**Bir yanlılık var ama ihmal edilebilir.** Model sürtünmeyi saf Coulomb (sabit) varsayıyor.
Viskoz bileşen varsa eğime karışır: `eğim = Ke + b_mek·R/Kt`. `b_mek ≈ 1×10⁻⁵` ile bu
`6.98×10⁻⁴`, yani Ke'nin **%1.8'i**. 1.73 katlık belirsizliği çözmeye çalışırken %1.8'lik
yanlılık sorun değil.

### Deney mevcut firmware'le, kod değişikliği olmadan yapılabilir

B "bugün yapılabilir" demiş ama nasıl olduğunu yazmamış. Kodda hazır duruyor (`foc_haptic.cpp:1114`):

```c
if (millis() < kickUntil) { lastT = kickDir * motor.voltage_limit; }
```

Yani `K <ms>` komutu **tam olarak sabit Uq basamağı** uyguluyor, genliği `voltage_limit`.
Ve `kickDir` konuma göre seçiliyor (`shaft_angle > midA() ? -1 : +1`), yani duvardan başlayınca
otomatik olarak karşı duvara doğru sürüyor — istenen yön.

Koşu şablonu:

```
v 0.4        # Uq = 0.4 V
B 0.5        # burst kaydini hiz tetiklemesiyle silahla
K 2000       # 2 sn sabit basamak
G            # tam dongu hizinda doku
```

`v` değerini 0.3 / 0.4 / 0.6 / 0.9 / 1.2 ile tekrarla. Firmware'e tek satır eklemeden.

### İki ekleme

**1. Taramayı iki yönde yap.** Coulomb sürtünmesi işarete bağlı: ileri yönde
`Uq = Ke·ω + V_f`, geri yönde `Uq = Ke·ω − V_f`. Dolayısıyla

- iki yönün eğim **ortalaması** = Ke (sürtünme sadeleşir)
- kesişimlerin **farkı** = 2·V_f

Bu, Ke'yi sürtünmeden tamamen arındırıyor. Ayrıca asimetri varsa (kablo demeti bir yöne
gerilirse) doğrudan görünür — ki uçlardaki davranışın sebebi tam da bu olabilir.

**2. Tek koşudan sürtünme HARİTASI çıkar.** Bu, tartışmayı başlatan soruyu doğrudan cevaplıyor.

Sabit Uq altında her açıda `ω(θ) = (Uq − V_f(θ))/Ke`. Yani **hız nerede düşükse sürtünme orada
yüksek.** Burst kaydı tüm geçişi tam döngü hızında tuttuğu için, tek bir duvardan duvara koşu
`V_f(θ)` eğrisini veriyor. "Uçlarda sürtünme 4–5 kat yüksek" iddiası (benim 1. turda yaptığım,
sonra 2 kata revize ettiğim) böylece tahmin olmaktan çıkıp ölçüm oluyor.

**Uyarı — uzamsal çözünürlük Uq'ya bağlı.** Elektriksel sönme sabiti ~18 ms; hız, sürtünme
değişimini bu gecikmeyle takip ediyor. ω = 15 rad/s'de bu **~15°'lik bulanıklık** demek.
Düşük Uq'da (ω ≈ 2 rad/s) bulanıklık ~2°'ye iniyor. Yani:

- **yüksek Uq** → temiz Ke eğimi (hız aralığı geniş)
- **düşük Uq** → ince sürtünme haritası (uçlar ayrışır)

Tarama ikisini de veriyor, ayrı deney gerekmiyor.

### Sıraya itirazım yok, tek düzeltmeyle

B'nin sırasında voltaj taraması EN pininin arkasında bekliyor. **Beklemesi gerekmiyor** —
tarama 12V kesmeyi, faz sökmeyi, enable pinini gerektirmiyor. Bugünkü donanımla yapılabilir.

EN pini 1. sırada kalsın ama **güvenlik gerekçesiyle**, deney önkoşulu olarak değil. Sönme
testi (3. madde) gerçekten onun arkasında; tarama değil.

### Durum

Ayrışmamız kalmadı. Açık olan tek şey sayılar: Ke, V_f(θ), b_el, J. Dördü de tek bir
tarama setinden çıkıyor ve set bugün çalıştırılabilir.

[SIRA: DIGERI]

---

## Uzman B — 9. tur

### A'nın iki eklemesi de doğru ve ben de kabul ediyorum

**Çift yön:** Coulomb sürtünmesi işarete bağlı olduğu için iki yönün eğim ortalaması Ke'yi
sürtünmeden arındırıyor, kesişim farkı `2·V_f` veriyor. Temiz. Üstelik `kickDir` konumdan
otomatik seçildiği için (`shaft_angle > midA() ? -1 : +1`) iki yön, **iki farklı duvardan
başlamakla** kendiliğinden elde ediliyor, ek komut gerekmiyor.

**Sürtünme haritası:** Sabit Uq altında `ω(θ) = (Uq − V_f(θ))/Ke` olduğu için tek geçiş
`V_f(θ)` eğrisini veriyor. Bu, tartışmayı başlatan "uçlarda sürtünme yüksek" iddiasını tahminden
ölçüme çeviriyor. Çözünürlük–hız takası analizi de doğru.

### Ama önerilen koşu şablonu bu firmware'de VERİ ÜRETMEZ

A'nın reçetesi `K 2000` ile basamağı uygulayıp burst kaydını bekliyor. Kodda bu çalışmaz
(`foc_haptic.cpp`, güncel satır numaraları):

```c
1114:    if (millis() < kickUntil) {   // TEKME: sabit tork darbesi, sonra birak
1115:      lastT = kickDir * motor.voltage_limit;
1116:      motor.move(lastT);
1117:      return;                    // ← burst blogunun ONUNDE cikis
       }
...
1205:    if (bIdx == -2 && fabsf(motor.shaft_velocity) > bTrigV) { bIdx = 0; bT0 = micros(); }
1206:    if (bIdx >= 0 && bIdx < BURST_N) {   // kayit
```

Tekme dalı, kayıt bloğuna **varmadan** `return` ediyor. Yani basamak uygulanırken tek örnek bile
kaydedilmiyor; kayıt ancak `kickUntil` dolduktan sonra, yani **serbest yavaşlama** fazında
başlıyor. Oysa ölçmek istediğimiz şey tam da basamak altındaki kararlı hız.

**İki satırlık düzeltme:** kayıt bloğu tekme dalının önüne alınsın (ya da tekme dalı `return`
yerine `goto`/bayrakla kayda düşsün). Bu yapılmadan tarama anlamsız veri verir.

Ayrıca tetik `motor.shaft_velocity` (LPF) ile karşılaştırıyor, kaydedilen ise `shaftVel()`
(gözlemleyici). Düşük Uq'da eşik seçerken bu fark akılda tutulsun.

### Süre ve güvenlik: `K 2000` yüksek Uq'da duvara çarpar

Kararlı hız `ω = (Uq − V_f)/Ke`. İki Ke adayı ve `V_f ≈ 0.25 V` ile beklenen değerler, ve
5.58 rad'lık (319.6°) yolun ne kadar sürede biteceği:

| Uq | ω (Ke=0.0394) | ω (Ke=0.0682) | geçiş süresi | önerilen `K` |
|---|---|---|---|---|
| 0.4 V | 3.8 rad/s | 2.2 rad/s | 1.5–2.5 s | 1500 ms |
| 0.6 V | 8.9 | 5.1 | 0.6–1.1 s | 600 ms |
| 0.9 V | 16.5 | 9.5 | 0.34–0.59 s | 300 ms |
| 1.2 V | 24.1 | 13.9 | 0.23–0.40 s | 200 ms |

`K 2000` ile 1.2 V verilirse knob ~0.3 saniyede duvara **14–24 rad/s ile çarpar** ve kalan
1.7 saniye boyunca tam voltajla duvara bastırır. Hem mekanik hem termal olarak istemediğimiz şey
(homing'de `homingV`'yi nazik tutma gerekçemizin aynısı). Süre Uq ile ters ölçeklenmeli.

### Bu tablo aynı zamanda deneyin cevap anahtarı

Tek bir koşu konvansiyon tartışmasını bitiriyor: **Uq = 0.6 V'ta kararlı hız ~9 rad/s çıkarsa
Ke ≈ 0.039; ~5 rad/s çıkarsa Ke ≈ 0.068.** Aradaki fark iki kat, ölçüm gürültüsünün çok üstünde,
yani tek bakışta ayrışıyor.

### Sıra konusunda A haklı

Taramanın EN pinini beklemesi gerekmiyor — 12V kesme, faz sökme, enable pini gerektirmiyor.
Sırayı düzeltiyorum:

1. **Burst kaydı düzeltmesi** (2 satır) — taramanın önkoşulu
2. **Voltaj basamağı taraması**, çift yön, süre Uq ile ölçeklenmiş → Ke, V_f(θ), b_el
3. **EN pini → GPIO + 10k pull-down** (güvenlik; ayrıca sönme testini yazılıma indirir)
4. Sönme testi → b_el ve J doğrulaması
5. Gerekirse K×B matrisi
6. `foc_haptic.cpp:259-270` yorumunun silinmesi

### Durum

Teknik ayrışmamız kalmadı. Elimizde ölçülecek dört sayı (Ke, V_f(θ), b_el, J), bunları veren tek
bir deney seti ve o setin önündeki iki satırlık bir kod engeli var.

[SIRA: DIGERI]

---

## Uzman A — 10. tur

### Kabul: reçetem veri üretmezdi

Doğruladım, B'nin gösterdiği satırlar birebir (`foc_haptic.cpp:1114-1118`):

```c
if (millis() < kickUntil) {
  lastT = kickDir * motor.voltage_limit;
  motor.move(lastT);
  return;                    // <-- kayit blogu 1205'te, buraya hic gelinmiyor
}
```

Basamak altında tek örnek kaydedilmiyor. "Mevcut firmware'le bugün yapılabilir" iddiam
yanlıştı — komutlar var ama birbirine bağlı değil. B'nin yakalaması yerinde.

Süre/güvenlik uyarısını da kabul ediyorum: `K 2000` + 1.2 V, knob'u 0.3 sn'de duvara çarpıp
kalan 1.7 sn tam voltajla bastırır. Süre Uq ile ters ölçeklenmeli.

### Ama ikinci ve daha büyük bir engel var: tampon yetmiyor

`BURST_N = 2500`, döngü bugün ölçülen **7699 Hz** → kayıt penceresi **324 ms**.

B'nin kendi geçiş süresi tablosuyla karşılaştırınca:

| Uq | geçiş süresi | gereken örnek | tampon (2500) karşılıyor mu |
|---|---|---|---|
| 0.4 V | 1.5–2.5 s | 11.500–19.250 | **%13–22** |
| 0.6 V | 0.6–1.1 s | 4.620–8.470 | %30–54 |
| 0.9 V | 0.34–0.59 s | 2.618–4.543 | %55–95 |
| 1.2 V | 0.23–0.40 s | 1.771–3.080 | %81–100 |

Yani sürtünme haritası için **en değerli koşu (düşük Uq, ince uzamsal çözünürlük) tamponun
5–7 katı** veri üretiyor. Yolun ilk beşte birini kaydedip kesiliyor — ve uçlardaki sürtünme
tam da yolun sonunda.

**Çözüm seyreltme.** Harita için 7.7 kHz gereksiz; uzamsal bulanıklık zaten 2–15°. 1:8
seyreltme → 962 Hz, 2500 örnek = **2.6 s**, tablodaki en yavaş koşuyu bile kapsıyor.

### Üçüncü ayrıntı: tetik, basamağın başını kaçırıyor

Kayıt hız eşiğiyle tetikleniyor (`bIdx == -2 && |v| > bTrigV`). Basamak testinde kaydın
**basamakla birlikte** başlaması gerekir, yoksa hızlanma geçişi kaybolur — ki `b_el` ve J
oradan çıkıyor. `K` komutu, kayıt silahlıysa `bIdx = 0; bT0 = micros();` yapmalı.

B'nin tetik notunu da ekliyorum: eşik `motor.shaft_velocity` (LPF) ile karşılaştırılıyor,
kaydedilen `shaftVel()` (gözlemleyici) — düşük Uq'da eşik seçerken bu fark önemli. Tetik
basamağa bağlanırsa bu sorun da ortadan kalkıyor.

### Taramanın gerçek önkoşulu: iki satır değil, üç küçük değişiklik

1. Tekme dalı kayıt bloğuna düşsün (`return` kaldırılsın ya da örnekleme fonksiyona çıkarılsın)
2. Burst kaydediciye seyreltme parametresi
3. `K`, silahlı kaydı anında başlatsın

Hiçbiri karmaşık değil ama "mevcut firmware yeter" doğru değil. Bunu ben iddia ettim, ben
düzeltiyorum.

**Not:** kullanıcının bu oturumdaki açık talimatı gereği (*"ben onaylamadan bir şey yapma"*)
bu değişiklikleri yazmadım, sadece tanımladım.

### Güncellenmiş koşu şablonu

```
v <Uq>                 # 0.4 / 0.6 / 0.9 / 1.2
B <tetik> <seyreltme>  # seyreltme: 0.4V->8, 0.6V->4, 0.9V->2, 1.2V->2
K <ms>                 # 1500 / 600 / 300 / 200  (Uq ile ters)
G                      # dok
```

Her Uq için iki duvardan birer koşu (yön `kickDir` ile otomatik).

### Durum

Teknik ayrışmamız yok. Tartışmanın çıktısı artık bir ölçüm planı ve onu mümkün kılan üç küçük
kod değişikliği. Dört bilinmeyen (Ke, V_f(θ), b_el, J) bu setten çıkıyor; Ke için ayırt edici
tahmin de net: **0.6 V'ta ~9 rad/s → Ke ≈ 0.039, ~5 rad/s → Ke ≈ 0.068.**

[SIRA: DIGERI]

---

## Uzman B — 11. tur

### Kabul: tampon hesabını ben de yapmamıştım

`2500 / 7699 Hz = 325 ms`. Süre tablosunu verirken tamponun kapasitesine bakmadım; en değerli
koşu (düşük Uq) tamponun 5–7 katı veri üretiyor. A'nın yakalaması doğru ve benim tablomun da
açığıydı.

### Ama iki amacı tek koşuya sıkıştırmak zorunda değiliz

Tampon sorunu, Ke ölçümü ile sürtünme haritasının **aynı koşudan** çıkarılmaya çalışılmasından
doğuyor. İkisinin gereksinimleri zıt:

| | gereken | süre | çözünürlük |
|---|---|---|---|
| **Ke + V_f (eğim/kesişim)** | sadece kararlı hız | kısa | tam hız şart değil |
| **V_f(θ) haritası** | tüm yol boyunca ω(θ) | uzun | ince uzamsal adım |

**Ke için uzun geçiş gereksiz.** Elektriksel sönme sabiti `J/b_el ≈ 6–18 ms`, yani kararlı hıza
**~50 ms**'de varılıyor. Ortadan başlayıp 150 ms'lik bir basamak yeterli: tam hızda 1.150 örnek,
tampona rahat sığıyor, duvara da varmıyor. Her Uq için iki yön = 8 kısa koşu.

Bu, tampon sorununu Ke tarafında tamamen ortadan kaldırıyor ve duvara çarpma riskini de siliyor.

### Harita için daha iyi bir yöntem: sabit voltaj değil, sabit HIZ

Sürtünme haritasını sabit voltajla çıkarmanın üç zayıflığı var:
1. Hız sürtünmeyle değiştiği için **uzamsal örnekleme düzgün değil** (sürtünmenin yüksek olduğu
   yerde knob yavaşlar, orada çok örnek; düşük olduğu yerde seyrek)
2. Bulanıklık hıza bağlı (A'nın 2–15° analizi)
3. Ölçülen büyüklük (hız) aradığımız büyüklüğe (sürtünme) **dolaylı** bağlı

Sabit hızla sürülürse:

```
U_komut(θ) = V_f(θ) + Ke·ω_sabit      (ω sabit → ivme terimi yok)
```

- Ölçülen büyüklük **doğrudan** komut voltajı; sürtünme sabit bir ofset çıkarılarak okunuyor
- Hız sabit olduğu için **uzamsal örnekleme düzgün**
- Bulanıklık her açıda aynı

Üstelik kod zaten var — `findWall()` içindeki hız P-kontrolü (`v = 0.6*(targetVel − shaft_velocity)`,
`homingV` ile sınırlı) tam olarak bu. Kaydedilecek şey `lastT`, zaten burst'ün üçüncü kanalı.

Sayılar: `ω = 2 rad/s` ile 5.58 rad = **2.8 s**. 1:16 seyreltme (481 Hz) → 1.340 örnek, tampona
sığıyor, uzamsal adım **0.24°**. A'nın önerdiği 1:8 bile yeterli olurdu ama 1:16 pay bırakıyor.

### Böylece gereken kod değişikliği küçülüyor

A'nın üç maddesinden ikisi yeterli:

1. **Tekme dalı kayıt bloğuna düşsün** — Ke koşuları için şart
2. **Seyreltme parametresi** — sadece harita koşusu için (1:16)
3. ~~`K` kaydı anında başlatsın~~ → Ke koşusunda basamak 150 ms, tetik eşiği düşük tutulursa
   (örn. 0.3 rad/s) kayıt zaten ilk birkaç örnekte başlar. Yine de A'nın önerdiği gibi `K`'nin
   kaydı doğrudan başlatması daha temiz; "gerekli" değil, "iyi olur".

Sabit hız koşusu için ek bir komut gerekebilir (`findWall` mantığını duvara dayanmadan, verilen
hızla tek geçiş yapan bir varyant). Bu, tekme dalı düzeltmesinden bağımsız, ~15 satır.

### Güncel plan

**A grubu — Ke ve V_f (kısa, güvenli, tampona sığıyor):**
```
ortadan basla, v <0.4|0.6|0.9|1.2>, K 150, G      × 2 yön
```
→ eğim ortalaması = Ke, kesişim farkı = 2·V_f, `b_el = Ke²/R`

**B grubu — sürtünme haritası (sabit hız, seyreltilmiş):**
```
duvardan basla, hiz 2 rad/s tek gecis, seyreltme 1:16, G
```
→ `V_f(θ)`, uçlardaki artış doğrudan görünür

**C — doğrulama (EN pini düzeltildikten sonra):** sönme testi → `b_el` ve J bağımsız doğrulama

### Durum

Ayrışma yok. Fark sadece şu: A'nın planı tek deneyle dört bilinmeyeni hedefliyordu ve tampona
takıldı; iki deneye bölünce hem tampon sorunu kalkıyor hem her ölçüm kendi sorusuna doğrudan
cevap veriyor. Gereken kod değişikliği de üçten ikiye (+ bir opsiyonel komut) iniyor.

[SIRA: DIGERI]

---

## Uzman A — 12. tur

### İkiye bölme doğru, kabul

Tek deneye dört bilinmeyen sıkıştırmam tamponu patlattı. B'nin ayrımı (Ke kısa koşuyla, harita
uzun koşuyla) hem tampon sorununu hem duvara çarpma riskini çözüyor. Benimkinden iyi.

### Ama 150 ms yüksek Uq'da duvara çarpıyor

Ortadan başlayıp her yöne 160° (2.79 rad) yer var. `V_f = 0.25`, `Ke = 0.0394` ile:

| Uq | ω | duvara varış | `K 150` |
|---|---|---|---|
| 0.4 V | 3.8 rad/s | 733 ms | güvenli |
| 0.6 V | 8.9 | 314 ms | güvenli |
| 0.9 V | 16.5 | **169 ms** | **çarpar** |
| 1.2 V | 24.1 | **116 ms** | **çarpar, 24 rad/s ile** |

Yüksek Uq'da sıkışma var: kararlı duruma `3τ ≈ 54 ms` gerekiyor, duvar 116 ms'de geliyor.
Pencere dar ama var. İki çözüm:

- **Yüksek Uq'da duvardan başla** (160° değil 319.6° yol) → 1.2 V'ta 232 ms, `K 150` güvenli
- veya süreyi ölçekle: 0.9 V → 80 ms, 1.2 V → 55 ms (3τ'nun hemen üstü, riskli)

Birincisi tercih edilir. Duvarda duruyorken statik sürtünme yüksek, bu ilk geçişi kirletir ama
kararlı hız bölgesini etkilemez.

### Sabit hız komutuna gerek olmayabilir — üç kanal zaten kayıtlı

B, harita için `findWall`'un hız kontrolünden türetilmiş ~15 satırlık yeni bir komut öneriyor.
Gerek olmayabilir, çünkü burst kaydedici **üç kanalı birden** tutuyor (`foc_haptic.cpp`):

```c
bAng[i] = shaft_angle;   bVel[i] = shaftVel();   bTrq[i] = lastT;
```

Yani her örnekte açı, hız ve **komut voltajı** var. Hareket denklemi:

```
(Kt/R)·(Uq − Ke·ω) = τ_f(θ) + J·α
τ_f(θ) = (Kt/R)·(Uq − Ke·ω) − J·α        α = dω/dt, hız izinden türetilir
```

Yani **sabit hız şart değil.** İvme terimi hesaba katıldığı sürece sabit voltajlı tek bir geçiş
de `τ_f(θ)` veriyor. B'nin sabit hız gerekçesi (düzgün uzamsal örnekleme) hâlâ geçerli bir
kolaylık ama **zorunluluk değil**.

Üstelik J de aynı izden çıkıyor: başlangıçta ω = 0 olduğu için

```
J = [(Kt/R)·Uq − τ_f] / α₀
```

kararlı hızdan gelen `τ_f` ile birlikte. Yani **tek geçiş Ke, τ_f(θ) ve J'yi birden veriyor.**

**Bir uyarı B'nin lehine:** P-kontrollü sabit hız gerçekte sabit olmaz. `P = 0.6 V/(rad/s)` ile
0.3 V'luk bir sürtünme değişimi 0.5 rad/s hız hatası yaratır — 2 rad/s hedefin %25'i. Yani o
yöntemde de hız izini kullanmak gerekiyor. İki yöntem bu noktada birleşiyor.

### Net sonuç: kod değişikliği ikiye iniyor

1. **Tekme dalı kayıt bloğuna düşsün** (ikimizin de kabul ettiği)
2. **Seyreltme parametresi** (harita koşusu için 1:8–1:16)

Üçüncü madde (`K` kaydı başlatsın) "iyi olur" seviyesinde — B haklı, düşük tetik eşiğiyle idare
edilebilir. Dördüncü madde (sabit hız komutu) **gereksiz.**

### Çalıştırma planı

**Ke + V_f** — her Uq için iki yön, uygun duvardan başla:
```
v <0.4|0.6|0.9|1.2>   B 0.3 1   K 150   G
```

**Harita** — düşük Uq, duvardan duvara, seyreltilmiş:
```
v 0.4   B 0.3 8   K 1500   G
```

Çıkan: eğim ort. → Ke, kesişim farkı → 2·V_f, `b_el = Ke²/R`, başlangıç ivmesi → J,
iz boyunca → `τ_f(θ)`.

Ayırt edici tahmin değişmedi: **0.6 V'ta ~9 rad/s → Ke ≈ 0.039; ~5 rad/s → Ke ≈ 0.068.**

### Tartışmanın durumu

Teknik ayrışma kalmadı. Sonuç: iki satırlık kod değişikliği, iki koşu grubu, dört bilinmeyen.
Ve değişmeyen tek öncelik, ikimizin de üçüncü turdan beri aynı yere koyduğu madde — **EN pini**.

[SIRA: DIGERI]

---

## Uzman B — 13. tur (kapanış)

### İki düzeltmeyi de kabul ediyorum

**Yüksek Uq'da ortadan başlamak çarpar.** Hesap doğru: ortadan yarım yol 2.79 rad, 1.2 V'ta
116 ms'de bitiyor, kararlı duruma 3τ ≈ 54 ms gerekiyor — pencere var ama dar. "Yüksek Uq'da
duvardan başla" çözümü doğru ve ben bunu atlamıştım.

**Sabit hız komutu gereksiz.** Hareket denklemine ivme terimini koyunca sabit voltajlı tek geçiş
de `τ_f(θ)` veriyor; üstelik P-kontrollü hız zaten sabit olmayacağı için iki yöntem aynı yere
çıkıyor. 15 satırlık komut önerimi geri çekiyorum.

### Ama J'yi başlangıç ivmesinden çıkarmak en gürültülü noktayı seçiyor

A'nın `J = [(Kt/R)·Uq − τ_f]/α₀` formülü iki sorunlu varsayım taşıyor:

1. **t = 0'da sürtünme kinetik değil statik.** Kopma torku Coulomb torkundan büyük ve bilinmiyor
   — zaten ölçmeye çalıştığımız şey. `τ_f`'yi kararlı hızdan alıp α₀'a uygulamak farklı rejimden
   bir sayıyı taşımak demek.
2. **α₀, konumun iki kez türevi.** 14-bit sensör + gözlemleyici, ivmenin en gürültülü olduğu
   anda değerlendiriliyor.

**Alternatif: tüm yükseliş eğrisine zaman sabiti uydur.** Basamak altında hız
`ω(t) = ω∞·(1 − e^(−t/τ))`, `τ = J/b_el`. Tek örnek yerine **yüzlerce örnek** kullanılıyor:

- `ω∞` → Ke (zaten istediğimiz)
- `τ` → `J = τ · b_el`, `b_el = Ke²/R_toplam` aynı koşudan
- Beklenen: `b_el ≈ 4.6×10⁻⁴` (R_toplam = 2.75 + 0.6 sürücü), J = 3.6×10⁻⁶–1×10⁻⁵ aralığı için
  **τ = 8–22 ms** → 7.7 kHz'de 60–170 örnek. Uydurma için fazlasıyla yeterli.

Yani kısa koşular tek başına **Ke, V_f, b_el ve J**'yi veriyor; harita ayrı koşu olarak kalıyor.

### Haritada ivme terimi ne zaman gerekiyor — sayıyla

`τ_f(θ) = (Kt/R)(Uq − Ke·ω) − J·α`. İkinci terimin ne zaman önemli olduğu:

- Sürtünme torku ölçeği: `V_f = 0.25 V × Kt/R = 0.0036 N·m`
- J = 1×10⁻⁵ ile `J·α` bunun yarısına denk gelmesi için `α ≈ 180 rad/s²`

Yani sürtünme yavaş değiştiği bölgelerde (`α` küçük) harita basitçe
**`V_f(θ) = Uq − Ke·ω(θ)`** ile okunuyor, ivme terimi gereksiz. Sadece **uçlarda** (sürtünmenin
hızla arttığı yer, zaten ilgilendiğimiz bölge) terim devreye giriyor. Pratik sonuç: ikisini de
hesapla, farkları sadece uçlarda ayrışır; ayrışma büyükse α tahmininin gürültüsü ölçünün sınırıdır.

### Üzerinde anlaştığımız final plan

**Kod (2 değişiklik):**
1. Tekme dalı kayıt bloğuna düşsün (`foc_haptic.cpp:1114-1118`'deki erken `return`)
2. Burst kaydediciye seyreltme parametresi

**Koşu A — Ke, V_f, b_el, J** (her Uq için iki yön; 0.9 ve 1.2 V'ta duvardan başla):
```
v <0.4|0.6|0.9|1.2>   B 0.3 1   K 150   G
```
→ `ω∞` eğimi = Ke · · kesişim farkı = 2·V_f · · yükseliş uydurması = τ → J

**Koşu B — sürtünme haritası** (düşük Uq, duvardan duvara, 1:8–1:16):
```
v 0.4   B 0.3 8   K 1500   G
```
→ `V_f(θ)`; uçlarda ayrıca `J·α` terimiyle kontrol

**Koşu C — doğrulama** (EN pini GPIO'ya alındıktan sonra): sönme testi → `b_el`, J bağımsız

### Ayırt edici tahminler (kayda geçsin)

| ölçüm | tahmin | yanlışlarsa ne demek |
|---|---|---|
| 0.6 V'ta `ω∞` | ~9 rad/s → Ke ≈ 0.039 · · ~5 rad/s → Ke ≈ 0.068 | ikisi de değilse Kt/R modeli hatalı |
| yükseliş `τ` | 8–22 ms | çok daha büyükse `b_el` hesabı (ikimizin dayanağı) yanlış |
| orta bölge `V_f` | 0.20–0.32 V | önceki statik çıkarımla tutmalı |
| uçlarda `V_f` | orta bölgenin 2–5 katı | tutmazsa "uçlarda sürtünme" tezi düşer |
| sönme testi `b_el` | Koşu A'dan çıkanla ±%30 | ayrışırsa elektriksel sönüm modeli eksik |

### Kapanış

Teknik ayrışmamız kalmadı; tartışma bir ölçüm planına dönüştü. Tartışma boyunca **çürütülen
iddiaların sayısı, ayakta kalanlardan fazla** — ve çürütülenlerin büyük kısmı ölçülmeden
yürütülmüştü (benim `0.83°` tahminim, atalet tahminim, est modu kanıtım; A'nın L298N direnç
modeli, `Kcenter` dışı hipotezler, tek koşuluk plan). Bu, A'nın açılış tezinin kendisini
doğruluyor.

Değişmeyen tek madde: **EN pini.** Üçüncü turdan beri ikimiz de listenin başına koyuyoruz ve
bu tartışmanın hiçbir çıktısı onun yerini almıyor.

[SIRA: DIGERI]

---

## Uzman A — 14. tur (kapanış)

### J düzeltmesini kabul

Başlangıç ivmesinden J çıkarmak iki kere hatalıydı: statik kopma torku kinetik Coulomb'dan
farklı (ve bilinmiyor), üstelik α₀ konumun iki kez türevi — gürültünün en yüksek olduğu nokta.
Yükseliş eğrisine `ω(t) = ω∞(1 − e^(−t/τ))` uydurmak yüzlerce örnek kullanıyor, doğrusu bu.

**Küçük bir ek:** uydurma ilk birkaç ms'yi dışlamalı. O aralıkta knob statikten kinetik
sürtünmeye geçiyor, yani sürtünme terimi sabit değil — birinci dereceden model orada geçerli
değil. `%20–%95 ω∞` penceresi temiz.

### J için üçüncü ve daha temiz bir yol: çentik kuyusunda serbest salınım

İkimizin de önerdiği J yolları Ke'ye ya da sürtünme modeline bağlı. Bağlanmayan bir yol var:

**Knob'u bir çentik kuyusunun içinde azıcık kaydır (yarım aralıktan az), bırak, salınımı kaydet.**

Testere profili hücre içinde doğrusal, yani bu gerçek bir yay-kütle sistemi. Çentik sertliğini
**tam olarak biliyoruz** (`Kdet = 22 V/rad`, kodda sabit):

```
K = 22 × Kt/R = 22 × 0.0143 = 0.315 N·m/rad
```

| J adayı | doğal frekans | ζ | kaynak |
|---|---|---|---|
| 3.6×10⁻⁶ | **47.0 Hz** | 0.22 | B'nin 47 Hz'den türettiği |
| 1.0×10⁻⁵ | **28.2 Hz** | 0.13 | geometrik tahmin (~30 g, r≈20 mm) |

**Ayırt edici tahmin:** serbest salınım 47 Hz çıkarsa B'nin ilk türetmesi doğruydu — ve o zaman
çırpıntıda ölçülen 47 Hz bir limit çevrimi değil, **sistemin doğal frekansıymış** demektir.
28 Hz çıkarsa geometrik tahmin doğru ve 47 Hz başka bir mekanizmaydı.

Bu yöntemin üstünlükleri:
- **Ke'ye hiç ihtiyaç yok** — konvansiyon tartışmasının tamamen dışında
- **Coulomb sürtünmesi frekansı etkilemez** (sadece sönme zarfını etkiler, o da doğrusal yapar).
  Yani J ölçümü sürtünme modelinden bağımsız temiz
- Hareket küçük: duvar riski yok, termal yük yok
- Her iki adayda da ζ < 0.25, yani birkaç çevrim görünür. 28–47 Hz'de 200 ms = 1.540 örnek,
  tampona rahat sığıyor, seyreltme bile gerekmiyor

**Dürüst sınır:** sönme zarfından `b_el` çıkarmak bu koşuda temiz değil, çünkü Coulomb sürtünmesi
doğrusal sönme, viskoz terim üstel sönme veriyor; ikisi karışıyor. Yani bu koşu **J'yi temiz,
`b_el`'i kirli** veriyor. Koşu A'nın tam tersi — ikisi birbirini tamamlıyor.

### Final plan (B'ninkine tek ekleme)

Koşu A (Ke, V_f, b_el, J), Koşu B (harita), Koşu C (sönme doğrulaması) aynen kabul.

**Koşu D — çentik salınımı, J çapraz kontrolü:**
```
m detent   b 0   k 22   B 0.3 1   (knob'u elle hafif kaydir birak)   G
```
Mevcut firmware'le, ek kod olmadan yapılabilir — tek koşu burada `K` komutuna bağlı değil.

### Kapanış

B'nin son tespitine katılıyorum ve altını çiziyorum: bu tartışmada **çürütülen iddia sayısı
ayakta kalandan fazla**, ve çürütülenlerin hepsinin ortak özelliği ölçülmeden yürütülmüş olması.
Benim açılış tezim buydu; tartışma onu kendi üzerimde de doğruladı — L298N direnç modelim,
çentik-savaşıyor teşhisim, tek koşuluk planım, J formülüm hep düştü.

Kalan tek madde ikimizin de aynı yere koyduğu **EN pini**. Bu tartışmanın ürettiği dört koşunun
üçü onsuz yapılabilir; dördüncüsü (sönme testi) onun arkasında bekliyor. Ve asıl mesele deney
değil: o pin düzeltilmeden knob her firmware yüklemesinde aynı riski taşımaya devam ediyor.

[SIRA: DIGERI]

---

## Uzman B — 15. tur (kapanış notu)

### Koşu D'yi doğruladım, planı tamamlıyor

Matematiği kontrol ettim, tutuyor: `f = (1/2π)√(K/J)` ile J = 3.6×10⁻⁶ → 47.1 Hz,
J = 1×10⁻⁵ → 28.3 Hz; sönüm oranları 0.22 ve 0.13. Coulomb sürtünmesinin frekansı
etkilemeyip sadece zarfı doğrusallaştırması da doğru. Bu koşu benim 5. turda işaretlediğim
"3 kat belirsiz atalet" açığını kapatıyor ve bunu Ke'den bağımsız yapıyor — planın eksik
parçasıydı.

**Elektriksel kutup kontrolü (koşunun temizliği için):** sargı zaman sabiti
`L/R = 704 µH / 3.35 Ω = 210 µs`, köşe frekansı ~760 Hz. Ölçeceğimiz 28–47 Hz'in 16–27 katı
üstünde, yani elektriksel dinamik mekanik salınımı bozmuyor. Koşu D bu açıdan temiz.

**Koşu D'nin ön koşulları** (yoksa ölçtüğümüz şey saf yay-kütle olmaz):
- `b 0` → hız sönümü kapalı (A zaten yazmış)
- `z 0` → ölü bölge kapalı; açıksa merkez civarında tork kesilir, salınım bozulur
- `E` ile est modu **kapalı** kalmalı (varsayılan kapalı) — açıksa `b_el` değişir, ζ kayar
- Genlik **yarım aralıktan belirgin küçük** (örn. ±3°, aralık 12.6°) → hem doğrusal bölgede
  kalınır hem `hapCenter` histerezisi tetiklenmez

### Uydurma penceresi notunu kabul

İlk birkaç ms'nin dışlanması (`%20–%95 ω∞`) doğru: orada statikten kinetiğe geçiş var, birinci
dereceden model geçerli değil.

### Kapanış

Dört koşunun üçü bugünkü donanımla, ikisi hiç kod değişikliği olmadan yapılabilir. Ben de
A ile aynı yerde bitiriyorum: sıradaki iş tartışmak değil **ölçmek**, ve ölçümden bağımsız
olarak düzeltilmesi gereken tek fiziksel madde EN pini.

Tartışma kapanmıştır; yeni veri geldiğinde yeniden açılabilir.

[SIRA: KAPANDI]
