ernerdl/smart-knob/hardware/as5600_braket_gap1.5.stl

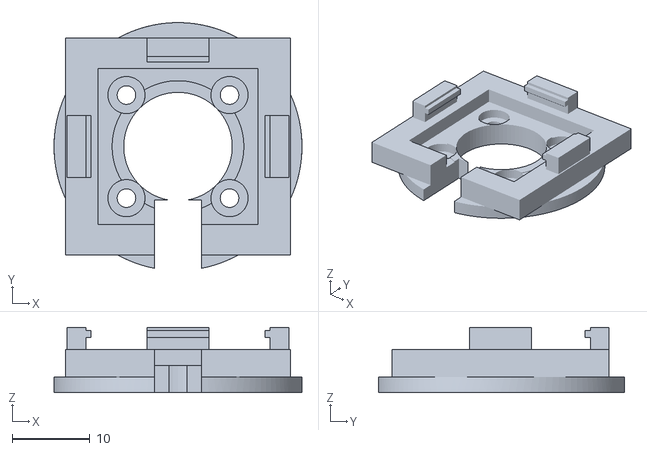
[picture p2: CAD file, 2026-07-27]
hardware/as5600_braket_gap1.5.stl
32.0 x 31.7 x 8.45
