ernerdl/smart-knob/hardware/as5600_braket_gap1.0.stl

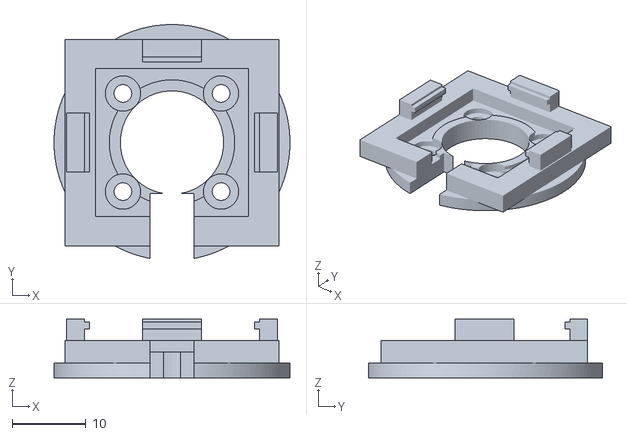
[picture p3: CAD file, 2026-07-27]
hardware/as5600_braket_gap1.0.stl
32.0 x 31.7 x 7.95
