ernerdl/smart-knob/(commit log)

2026-07-27 baseline: forcing kaldirildi, space goreli (A - calisir, saccmalama yok)
    - forcing tamamen kaldirildi (sync motoru surmez)
    - VOLUME: mutlak + yazilim duvarli
    - SPACES/TABS: duvarsiz goreli (relAnchor delta -> adim), LED kozmetik (dispIdx)
    - kullanici onayladi: titreme/saccmalama gitti
    [as5600_braket_gap1.0.stl, as5600_braket_gap1.5.stl, as5600_braket_gap2.0.stl]
2026-07-27 B: VOLUME dis-senkron icin ESKI SERT forcing geri (1.5sn, Kforce=18)
    - forcing SADECE volume repoze (menu cubugundan ses degisince knob o seviyeye HIZLA gider)
    - dogrudan yay + 1.5sn HARD timeout (yavas kritik-sonumlu 3sn DEGIL) -> savas penceresi kisa
    - SPACES/TABS goreli KALIR (forcing orada asla tetiklenmez, wall-fix korunur)
    - VOL komutu forcing tetigi + detent takibinde !forcing guard geri
    [foc_haptic.cpp]
2026-07-27 B IPTAL -> A'ya donuldu: forcing HER FORMDA ses'te saccmaliyor (sert hali de)
    - kullanici: 'ses de en ufak degisiklikte saccmaliyor'
    - sonuc: forcing artik hangi ayarla olursa olsun savasiyor (MT6701 gurultu + geometri) -> tamamen kaldirilmis A hali dogru
    - sonraki: space LED senkronu (SP->dispIdx, buton bagli) A uzerinde calistirilacak
2026-07-27 C: HERSEY GORELI + mod-gecisi ORTALAMA (fiziksel ~300deg limit cozumu)
    - VOLUME de goreli oldu (konum=deger eslemesi kalkti) -> mod gecisinde konum cakismasi yok
    - mod degisince motor bir kerelik fiziksel ORTAYA doner (centering): SABIT hedef, nazik (2.5V cap),
    kullanici merkezden uzaga iterse ANINDA iptal (e*vel>2) -> savasamaz, forcing gibi degil
    - hapticTorque: tum modlar duvarsiz sonsuz grid; yazilim duvari kaldirildi (fiziksel stop tek sinir)
    - VOL/SP/TAB sync SADECE LED boyar (motor asla)
    - senaryo cozuldu: space'te duvara dayanip sese gecince ortalama yer acar, sesi acabilirsin
2026-07-27 C fix: ekran/displayTask space'te dispIdx gosterir (level degil) -> '9/3' bug + space gecis bildirimi
    - drawScreen: shown = volume?level:dispIdx (N/M ve bar dogru)
    - displayTask degisiklik algisi dispIdx'i de izler -> space degisince ekran yenilenir
    - VOL komutu LED barini gunceller (kullanici cevirmiyorken)
    [foc_haptic.cpp]
2026-07-27 8 buton konfigurasyonu + UI esleme + parlaklik + scroll + deploy-cikis fix
    - 8 buton -> aksiyon haritasi (btnAction[8]); UI'dan 'ogren + fonksiyon' ile eslenir (fiziksel sira karisik olsa da)
    - yeni modlar: PARLAKLIK (HS hs.brightness, HYPER +/-), SCROLL (native Mouse tekeri, HS yok, her uygulamada)
    - app ac/odakla: Claude/Fusion (HYPER harf -> HS launchOrFocus); Elegoo DUSURULDU -> yerine SCROLL
    - serial: BTN <bit> <act>, BTNMAP?, BTNPRESS <bit> (UI ogren); firmware enum ACT_*
    - HS: f14=parlaklik modu, HYPER =/- parlaklik, HYPER j/g claude/fusion
    - FIX: deploy'a yanlislikla girince baska mod butonu artik cikariyor (depState=OFF; ceza suresi korunur)
    - UI: knob_web.py buton esleme paneli (8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
    [foc_haptic.cpp, knob_web.py]
2026-07-27 UI: native (usbmodem) portu otomatik sec — buton ogrenme calismamasinin sebebi
    - firmware Serial NATIVE USB'de; usbserial = sadece flash UART (okuma/yazma yok)
    - panel eskiden son sirali portu (usbserial) seciyordu -> BTNPRESS/CFG hic okunmuyordu
    - refresh() artik usbmodem'i otomatik secer + dropdown'da etiketler (native vs flash)
2026-07-27 buton haritasi TERS sirali varsayilan (fiziksel alt/ust duzeltme)
    - bit0..7 = scroll,fusion,chrome,claude,deploy,parlaklik,space,ses
    - panel usbserial'e baglaniyordu (flash UART) -> learn calismiyordu + flash'i bloke ediyordu; auto-select native fix zaten commit'li
    [foc_haptic.cpp]
2026-07-27 scroll = serbest spin + ince tik; parlaklik = sistem parlaklik tus olayi
    - SCROLL: hapticTorque 0 (centik yok, serbest), detentSpacing 0.055 (~3° = 1 tekerlek tiki) -> responsive
    - PARLAKLIK: hs.brightness bu Mac'te nil (harici monitor) -> hs.eventtap newSystemKeyEvent BRIGHTNESS_UP/DOWN
    (klavye parlaklik tusu gibi, saglam). BR senkronu okunamazsa atlanir (LED optimistik)
    [foc_haptic.cpp]
2026-07-29 deploy sonrasi space titremesi: ortalama sonumu 0.3->1.4 (overshoot yok) + deploy cikisinda relAnchor tazele
    - centering merkez etrafinda dusuk sonumle salinip titriyordu -> guclu sonum kritik-ustu yapar
    - deploy DEP_OFF'a donunce bayat grid referansi jerk yapiyordu -> relAnchor=aci, centering=false
    [foc_haptic.cpp]
2026-07-29 deploy: sifre oncesi knob'u ORTALA (DEP_CENTER) -> sag3/sol5/sag7/sol1 tiklar sigar
    - depEnter DEP_CENTER'a girer: midA'ya guclu sonumle git, oturunca DEP_ENTRY (depAnchor=merkez)
    - 1.5sn timeout (oturamazsa yine de basla). Ekran: ORTALANIYOR
    - sebep: knob duvara yakin baslarsa alternatif tiklar cenik bitince sigmiyordu
    [foc_haptic.cpp]
2026-08-21 L6234'e gecis: enable pin (GPIO21) + voltajlari dusur (align/limit 3V)
    - BLDCDriver3PWM(15,16,17, PIN_MOTOR_EN=21) -> SimpleFOC EN'i surer (failed-to-notice-movement cozumu)
    - EN GPIO21'e + 10k pull-down GND'ye (boot-safe, uzman notu)
    - voltage_sensor_align 7->3, motor.voltage_limit 5->3, driver.voltage_limit 8->12
    - L298N kaldi (dusum yok, GBM2804 yuksek direncli -> dusuk voltaj)
    [foc_haptic.cpp, pins.h]
2026-08-21 L6234 kalibrasyon: align 4.5->2.5 (nazik, overshoot yok) + F komutu (HID yon ters cevir)
    - align voltaji dusuk -> temiz pp/hizalama -> tutma torku (centik) gelir
    - stepSign + 'F' komutu: L6234 faz yonu tersledigi icin HID/LED yonunu ceviririr
    - USB.begin setup basinda (debug icin serial her zaman yasar)
    [foc_haptic.cpp]
2026-08-21 L6234 voltaj duzeltme: align 2.5->5, voltage_limit 3->4 (~1.8V dusum geri hesaba katildi)
2026-08-21 L6234 TAM guc: align 7V, voltage_limit 6V (L298N-esdeger, dusum az=daha guclu centik)
2026-08-24 klasik ESP32 test karti (S3 yandi): bringup32/foc32 env + oto-stop guvenlik + pin override
    - env:bringup32 / foc32 (board=esp32dev) — sadece motor+sensor+L6234 testi (HID/ekran yok)
    - motor pinleri 25/26/27 (klasik ESP32'de guvenli; GPIO16 WROVER'da PSRAM, GPIO15 strapping)
    - I2C 18/19 (GPIO6 klasik ESP32'de FLASH, kullanilamaz)
    - pins.h #ifndef ile override edilebilir yapildi
    - bringup: 4sn komut yoksa OTO-STOP + motor.disable() (donmeyen motor isiniyordu)
2026-08-26 FOC'u ayri cekirdege al (core 0) + olculmus haptik ayarlarini kalici yap
    - focTask: core 0, oncelik 5, sadece loopFOC+tork+move. Olculen dongu: 9600 Hz.
    Ekran gorevi core 0'dan core 1'e alindi; HID/buton/seri zaten loop'ta (core 1).
    - disableCore0WDT() (tight loop), focPause/focResume ile homing ve P kalibrasyonu
    sirasinda cift move() cagrisi engellendi.
    - Yeni 'R' komutu: FOC dongu hizini Hz olarak olcer.
    - Kalici ayarlar: Kdet 40->22, damping 0.30->0.15, deadZone 0.010->0.012,
    motor.voltage_limit 4.0->4.5.
    Sonum olcumu: 0.15->2 cirpinti, 0.35->14, 0.55->47 (yuksek sonum titreme BESLIYOR).
    [bringup_openloop.cpp, foc_haptic.cpp, foc_test32.cpp, i2c_scan32.cpp, pin_test32.cpp, pins.h]
2026-08-26 Ayri cekirdek VARSAYILAN OLARAK KAPALI + bootta homing yok
    Regresyon: FOC'u ayri cekirdege alinca (9.6 kHz) centiklerde titreme cikti.
    Dongu hizini dusurmek de duzeltmedi (4 kHz az, 2 kHz DAHA KOTU) -> hipotez
    (hiz tahmini gurultusu) tek basina aciklamiyor. Kanitlanmis his geri getirildi:
    FOC yine loop() icinde.
    - focStep() ayri fonksiyon; FOC_SEPARATE_CORE=0 iken loop()'tan, 1 iken core 0
    gorevinden cagriliyor. Kod duruyor ama kapali (ekran baglaninca tekrar bakilacak).
    - Bootta home() YOK: duvara 4.5V ile dayanmak stall demek -> guc kaynagi CC'ye
    giriyor, motor isiniyor. Gunluk kullanim goreli grid; duvarlari bilmesi gerekmiyor.
    Nominal aralik = mevcut konum +/-159 deg. Gercek homin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
    [foc_haptic.cpp]
2026-08-26 Bootta CC: motor PWM hatlarini setup'in ILK isi olarak LOW'a cek
    Teshis (kullanicinin testiyle): CC sadece 'motor bagli + 12V acik + RST' halinde
    yaniyor; 12V'u acip kapatmakta yok. Yani sebep reset gecici durumu degil,
    firmware baslayana kadarki bosluk.
    EN pini 3V3'e sabit -> L6234 reset boyunca AKTIF. IN1/2/3 o sirada yuksek
    empedansta kalinca cikislar tanimsiz olup motora DC basiyor. Sure = ROM boot +
    delay(800) + LED init ~ 1-2sn. PWM pinlerini setup'in ilk satirinda LOW'a cekince
    1-2sn -> 0.5sn (kalan = ROM bootloader, yazilimla kapatilamaz).
    KALICI COZUM DONANIMDA: IN1/IN2/IN3'e 10k pull-down (GND'ye), 1k seri dirençlerin
    surucu tarafina. O zaman ESP resetteyken de, hic beslenmiyork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
    [foc_haptic.cpp]
2026-08-26 Hiz tahmini: min_elapsed_time 100us->500us, LPF Tf 0.03->0.01
    Gece arastirmalarinin (7 rapor) ortak sonucu: titremenin kaynagi sensor degil,
    kuantize acinin sonlu farkla turevlenmesi.
    1) SimpleFOC Sensor::getVelocity() icinde 'if (Ts < min_elapsed_time) return velocity'
    var; varsayilan 100us. 9600 Hz'de periyot 104us -> tam sinirda, bazi turlarda
    BAYAT hiz donuyordu. Bu, 'ayri cekirdek titretti' gozleminin kod duzeyindeki
    aciklamasi. 500us pencere ayrica kuantizasyon gurultusunu ~5 kat dusuruyor.
    2) Tf 0.03s (kesim 5.3 Hz, ~30ms gecikme) -> 0.01s (16 Hz, ~10ms). Gecikmis hizla
    yapilan sonum enerji sonduremeyip enjekte ediyordu.
    Pasiflik notu: raporlar arasinda celiski vardi. R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
2026-08-27 Merkez histerezisi DENENDI ve KAPATILDI + burst kaydedici + olcum araclari
    Yeni tani araci: 'B <hiz>' ile hiz tetiklemeli, TAM DONGU HIZINDA RAM kaydi (2500
    ornek), 'G' ile dokum. Seri telemetri 167 Hz'di; bu 7500+ Hz'de kaydediyor.
    ILK KEZ OLCULEN GERCEK DONGU HIZI: ~7500-8500 Hz (loop() icinde).
    Bu, dunku 'ayri cekirdek titretti' bilmecesini KESIN kapatiyor:
    loop() icinde periyot 133 us -> SimpleFOC'un 100 us esiginin ustunde (guvenli)
    ayri cekirdekte 104 us -> tam sinirda -> bazen BAYAT hiz donuyordu
    Hiz sadece %27 artmisti ama tam o esigi kesiyordu. min_elapsed_time 500 us
    oldugu icin bu tuzak artik kapali; ayri cekirdege guvenle donulebilir.
    Olculen salinimlar: 8 Hz (mekan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
2026-08-27 ESTIMATED CURRENT modu VARSAYILAN + sonum sorusu KAPANDI
    Motor olculdu/tanimlandi: 2805, 140KV, faz-faz direnc 5.51 ohm (uc kombinasyon da
    ayni -> yildiz sarim) -> faz direnci 2.75 ohm, Ke = 0.0394 V.s/rad.
    SimpleFOC estimated current: phase_resistance girilince target AKIM olarak
    yorumlaniyor (voltage.q = target*R + voltage_bemf); KV girilince geri-EMK ileri
    beslemeyle telafi ediliyor. Tork komutu lastT/phaseR ile olceklendi, yani uygulanan
    voltaj ONCEKIYLE AYNI — tek degisen geri-EMK telafisi.
    OLCUM (tetik 12 rad/s, ayni enerjiden baslayan adil karsilastirma):
    est KAPALI, K=22, b=0.15 : tepe 17 rad/s, 53 deg, HIC SONMEDI, son80ms std 1.32
    est ACIK, K=22, b=0.15 : tepe 93 rad/s,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
2026-08-27 COZULDU: centigin gucunu ARALIK verir, kararsizligi SERTLIK verir
    Kalici ayar: volSpacing 0.15 -> 0.327 rad (8.6 -> 18.7 deg, 17 centik fiziksel
    aralia yayilir), Kdet 22, damping 0.15 -> 0.0, deadZone 0, testere profili,
    voltage_limit 5.0, estMode kapali.
    Tepe kuvvet 0.53V (sinus) / 1.65V (dar testere) -> 3.6V. KARARLI ve GUCLU.
    Iki gunun kok hatasi: gucu SERTLIKTEN aramak. Testere profilinde
    tepe kuvvet = Kdet*sp/2 (aralikla dogru orantili)
    sinir egimi = Kdet (araliktan BAGIMSIZ)
    Yani sertligi artirmak guc vermiyor, sadece egimi dikleştirip kararsizlik
    yaratiyor. Guc araliktan gelir. Biz Temmuz'da goreli grid'e gecerken araligi
    18.8 -> 8.6 deg yarilamisiz; zayifligin se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
2026-08-27 Kalici: aralik 12.6 deg + sonum 0.05 (iki centik arasi gelgit icin)
    volSpacing 0.327 -> 0.220 rad (18.7 -> 12.6 deg): kullanici daha sik centik istedi.
    Tepe kuvvet 3.6 -> 2.4 V (hala eski dar-aralik ayarinin 4 katindan fazla).
    Kdet 22 sabit -> sinir egimi degismedi -> kararlilik korundu.
    damping 0 -> 0.05: sonum SIFIRKEN knob hafif savurmadan sonra iki centik ARASINDA
    gelgit yapip takiliyordu (kullanici: 'can titrer gibi'). 0.05 bunu kesiyor.
    Bu, eski 0.15-0.30'un ucte biri ve amaci FARKLI: cinlamayi sondurmek degil,
    sinirda takilmayi engellemek. Buyutmeyin.
    Enerji dengesi olculdu (tork*hiz integrali): verilen 3.9 / yutulan 6.9 / net -3.0.
    Bes zaman diliminin hepsinde net negatif -> kendi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
2026-08-27 Ekran + PCF + LED baglandi; ekran yonu 3 -> 1 (kasaya ters vidalanmis)
    Donanim artik tam: motor + MT6701(SSI) + L6234 + ST7789 + PCF8574 8 buton +
    16 LED WS2812 halka. Hepsi calisiyor.
    - tftRot degiskeni eklendi (varsayilan 1). 'u <0-3>' ile calisirken cevrilir.
    - 'n' komutu: renk barli ekran test deseni (kablolama/rotasyon dogrulama).
    - Kart env:foc ile yuklu birakildi (TinyUSB HID aktif = gunluk kullanim sürümü).
    LED besleme notu: WS2812B 5V (12V YAKAR). Halka buck 5V'tan DOGRUDAN beslenir,
    ESP USB'den. Buck'tan ESP'ye giden tek sey GND. Boylece USB cikinca ESP soner,
    3V3 kaybolur, L6234 EN duser ve motor 12V takili olsa bile sessiz kalir.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
2026-08-27 LED pin yorumu duzeltildi + GPIO4 kare dalga testi ('Z')
    pins.h'de uc celisen bilgi vardi: define 4, yorum 'GPIO14', v1 dokumani '7'.
    Firmware 4'u suruyor; yorum duzeltildi.
    'Z' komutu: GPIO4'u 1 Hz'de 10 sn yakip sondurur — multimetreyle pin+kablo testi.
    LED ARIZASI (27.08 aksami, cozulmedi): veri hatti SAGLAM (GPIO'da 3.3V),
    5V beslemesi YOK. Halka bacaginda olculen 1.9V gercek besleme degil, HAYALET
    BESLEME: WS2812 giris koruma diyotlari DIN'den VDD'ye siziyor. (Sensorde
    birebir ayni belirti yasanmisti — kablo hic bagli degildi.)
    Buck cikisinda 5V VAR -> ariza buck ile halka JST'si ARASINDA.
    [foc_haptic.cpp, pins.h]
2026-08-31 LED0 arizali: yazilimda atlandi + surekli yenileme komutu ('W')
    TESHIS (31.08): halkanin ilk WS2812'sinin ISIK kati olu, VERI aktarma kati SAGLAM
    -> arkasindaki 15 LED normal yaniyor. Cip degistirmeye gerek yok.
    LED_OFF=1 / NLED_USE=15 ile fiziksel index 0 kullanim disi; gosterge 1..15'e
    yayiliyor, leds[0] her zaman siyah. Cip degistirilirse LED_OFF'u 0 yap.
    Muhtemel sebep: beslemesiz halkaya veri basmak. WS2812'nin giris koruma diyotlari
    DIN'den VDD'ye siziyor, cip yarim besleniyor. Buck-JST arasindaki 5V kopuklugu
    duzelene kadar bunu birkac kez yaptik (benim 'L' komutum dahil).
    KURAL: halkada 5V olmadan veri hattini surme.
    Yeni komut 'W': 15 sn boyunca 50 Hz'de surekli LED yenileme. Tek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
    [bringup_openloop.cpp, foc_haptic.cpp]
2026-08-31 Kalibrasyon yenilendi (braket degisimi sonrasi) + P komutu artik ZORLA kalibre ediyor
    BELIRTI: braket yenilenip sensor yeniden monte edildikten sonra motor vizildiyor,
    centikler bozuk.
    SEBEP: zero_electric_angle SABIT kodluydu (0.227/CCW) ve sensorun rotora gore
    acisal konumu degistigi icin GECERSIZ kalmisti. Yanlis elektriksel aci = tork
    yanlis yonde uygulaniyor.
    'P <pp>' komutu kalibrasyonu ATLIYORDU: SimpleFOC, zero_electric_angle ve
    sensor_direction doluysa hizalamayi yapmiyor. Artik ikisini NOT_SET/UNKNOWN yapip
    initFOC cagiriyor -> gercek kalibrasyon.
    YENI DEGERLER: uc ardisik olcum 1.304 / 1.304 / 1.315 (yayilim 0.011 rad), yon CW.
    Eskisi CCW idi -> sensor yeni brakette ters yonde b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
2026-08-31 Cevirme yonu duzeltildi (knobDir) — FOC kalibrasyonuna dokunmadan
    Sensor yeniden monte edilince sensor_direction CCW -> CW dondu ve kullanicinin
    cevirme yonu tersine gecti. sensor_direction OLCULMUS ve DOGRU bir deger oldugu
    icin ona dokunulmadi (degistirmek FOC'u bozar).
    Bunun yerine kullaniciya donuk yon ayrildi: relAnchor hala FIZIKSEL yonde kayiyor,
    ama sayim/HID/LED 'uStep = step * knobDir' uzerinden gidiyor. knobDir = -1.
    'N' komutu ile calisirken ters cevrilebilir.
2026-09-01 Tani araclari: HIDTEST komutu + '?' ciktisinda GATE satiri
    BELIRTI (01.09): knob space modunda, cevirince adimlar SAYILIYOR (STEP satirlari var,
    ekran guncelleniyor) ama macOS'ta hicbir sey olmuyor.
    Zincir parca parca test edildi:
    sensor/adim -> OK (12 sn'de 44 STEP, aci 220 deg gezindi)
    HID -> OK ('HIDTEST' ile space 4->5->6->7, ucu de calisti)
    macOS kisayol-> OK (symbolichotkeys 79-82 acik)
    Yani sorun ADIM ile sendStep ARASINDA: gonderimi bekleten dort kapidan biri kapali.
    '?' artik su satiri da basiyor:
    GATE pending=<birikmis adim> hidRel=<tus birakilmadi mi> forcing=<eski guard>
    nextIn=<sonraki gonderime kalan ms> modeYasi=<mod degisiminden beri ms> appMode=<mo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
2026-09-02 Tani: '?' artik ADIM SAYMA blogunu da olcuyor + esik geri 0.85
    02.09'da butun modlarda adim sayilmadi. Once esigi (fwdThrK 0.85) suclayip 0.70'e
    cektim — YANLISTI. Zaman cizelgesi: esik 31.08 14:18'de degisti ve dun ogleden sonra
    saatlerce sorunsuz calisti. Esik sebep olsaydi SUREKLI bozuk olurdu, aralikli degil.
    Ayrica 'duzelme'yi esige yazdim ama ayni anda FLASH atmistim — asil duzelten RESET'ti.
    Esik 0.85'e (kullanicinin onayladigi his) geri alindi.
    12V dongusu KONTROLLU olarak denendi, tetiklemedi: 12V kesikken bile sensor okuyor,
    ekran guncelleniyor, cevirince degerler degisiyor (sadece motor torku yok). Geri
    verince sorunsuz. Yani tetikleyici 12V DEGIL.
    Iki arizanin ortak noktasi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
    [foc_haptic.cpp]
2026-10-14 HS: sendLine artik surec acmiyor + periyodik GC (7 gunde 824 MB sizinti)
    Hammerspoon 7 gunluk calismada 824 MB'a cikmisti. Canli surecte olculdu:
    hs.execute 2.4 KB kalici iz / cagri
    hs.task.new+start 2.7 KB kalici iz / cagri
    io.open+write+close 0
    Mekanizma: bu cagrilar ObjC tarafinda nesne birakiyor ve ancak Lua GC'si
    calisinca serbest kaliyor. Lua yigini ~900 KB oldugu icin GC'nin tetiklenmesi
    icin hicbir sebep yok, izler birikiyor. Lua yiginin kendisinde sizinti YOK
    (zorlanmis GC sonrasi 20 sn'de 0 KB buyume). mouseMoved eventtap'i de masum
    (saniyede ~450 olay, buyume yok).
    Baskin kaynak raporlanan sendLine degil, brLevel()'in 2 sn'lik ioreg'iydi:
    302.400 cagri x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
2026-10-14 HS: parlaklik yoklamasi olay tabanli — gunde 43.200 ioreg sureci gitti
    Onceki commit sizintinin akisini kesti ama kaynagini birakmisti: onBright()
    2 sn'de bir KOSULSUZ caliyor, her seferinde ioreg icin ayri bir surec aciyordu.
    Gunde 43.200 cagri, cevap neredeyse her zaman ayni ve ESP'ye hicbir sey gitmiyor.
    Masrafin tamami sormakta, gondermekte degil.
    Parlaklikta macOS olayi "yok" diye biliniyordu. Olculdu: systemDefined eventtap
    parlaklik tuslarini goruyor (BRIGHTNESS_UP/DOWN, down+up). Dogrulandi: knob
    SPACES modundayken parlaklik tusuna basildi, BR 9 -> BR 10 gonderildi.
    Artik ioreg sadece su anlarda calisiyor:
    - klavye parlaklik tusu -> yeni systemDefined eventtap
    - knob ceviri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
2026-10-14 HS: setKnobMode mod degismediyse push etmiyor
    Knob her 10 sn'lik SYNC'e modunun F-tusuyla cevap veriyor, HS de bunu mod girisi
    sayip pushState ediyordu. Yani mod hic degismese bile 10 sn'de bir durum yeniden
    okunup gonderiliyordu.
    Ses/space'te maliyeti sifirdi (HS'in kendi API'leri), ama parlaklik modunda ioreg,
    tabs modunda Chrome'a AppleScript bosuna tekrar calisiyordu. Bir onceki commit'te
    brPoll'dan sokulen yoklama, SYNC yolundan geri sizmis durumdaydi.
    Dogrulandi: 2.5 dk boyunca tek bir periyodik push yok (eskiden ~15). Gercek
    olaylar (onSpace) ve gercek mod degisimi push etmeye devam ediyor.
    BEDELI: knob yeniden baslar ve HS'in bildigi modla AYNI moda acilirsa RAM'i bos
    kalir; ilk g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
2026-10-14 Duvarlar sabit + ses/parlaklikta mod girisinde konum + space Kdet 30 + LED duzeltmesi
    DUVARLAR SABIT (min 6.7, max 326.3 deg — 'H' homing ile olculdu)
    Bootta homing yok; eskiden yerine "mevcut konum ortadadir" varsayilip minA/maxA
    a0 +-159 yapiliyordu. Dock takilinca USB gidip gelip ESP resetleniyor, knob o an
    neredeyse orasi merkez sayiliyor, bir sonraki mod degisiminde ortalama knob'u oraya
    suruyordu: "knob hangi taraftaysa o tarafa dayaniyor". MT6701 mutlak oldugu icin
    duvarlar resetten sonra da ayni; bir kez olcmek yetiyor. Braket sokulurse
    zero_electric_angle ile birlikte yenilenir. 0/360 donum noktasi olu bolgede
    kaliyor (kontrol edildi), minA<a<maxA kiyaslamasi sorunsuz.
    SES/PARLAK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
    [foc_haptic.cpp]
2026-10-14 Mutlak konumlandirma: 3.04 -> 0.09 derece + 'g' test komutu + bayat yorumlar
    KONUMLANDIRMA
    Mod girisinde knob'u seviyenin acisina goturen mekanizma calismiyordu: 6 hedeften
    2'si zaman asimina dusuyordu (sol duvar -3.04 deg, sag duvar +0.133 deg).
    Kok sebep fizik degil, miras alinmis bir varsayilan: yol fazi Kcenter=6 kullaniyordu.
    O deger "mod degisince knob'u kabaca ortaya it" rutininden geliyor, konumlandirma icin
    secilmemisti. Takilma hatasi = surtunme / sertlik:
    6 -> 0.318V/6 = 3.04 deg -> tutma fazinin 3 deg'lik kapisinin DISINDA kaliyordu
    22 -> 0.318V/22 = 0.83 deg -> rahat iceride
    Kilitlenme buydu: integrale ulasmak icin yaklasmak, yaklasmak icin integral gerekiyordu.
    Degisi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
    [bringup_openloop.cpp, foc_haptic.cpp, pins.h]
2026-10-14 Duzeltme: elektriksel sonum ihmal edilmiyor -- iki yerlesik aciklama yanlisti
    Voltaj modunda tork = (Kt/R)(Uq - Ke*w). Ikinci terim hiza orantili KARSI tork, yani
    bir sonum: b_el = Kt*Ke/R = 0.0394^2/2.75 = 5.6e-4 N.m.s/rad. Formul firmware'in kendi
    yorumunda (satir ~258) zaten yaziliydi; ikinci terimin sonum oldugunu kimse fark etmemis.
    1) README'deki L298N aciklamasi
    "Kayiplari sonum sagliyordu" demistik. b_el dirençle TERS orantili, yani L298N'in
    Darlington dusumu sonumu AZALTIYORDU. L6234 aslinda 1.5-2.5 kat daha fazla sonum veriyor.
    Gercek mekanizma ölü bölge: sabit ~1.8 V dusum, 5 V olceginde komutun ilk %36'sini
    yutuyordu -> kucuk genlikli limit cevrimleri doğamıyordu. Sonum de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
    [foc_haptic.cpp]
2026-10-15 Ses/parlaklikta MUTLAK esleme + cift yonlu geri besleme + oto-ortalama
    MUTLAK ESLEME (ses/parlaklik)
    Konumun KENDISI seviye. Goreli adim yerine acidan hesaplanan hedef seviyeye kac adim
    gerekiyorsa o kadar HID gidiyor. Adim kaybolsa ya da deger disaridan degisse bir sonraki
    cevirmede kendini duzeltiyor -- gercek bir potansiyometre gibi. Histerezis korundu.
    YON HATASI DUZELTILDI
    levelAngle() seviyeyi hep ARTAN aciya esliyordu. knobDir=-1 oldugu icin bu TERSTI:
    ses 0 kullanicinin SAGINA dusuyordu, oysa solunda olmali. Artik esleme knobDir uzerinden
    kuruluyor (barLevel0 + knobDir*lv*sp).
    ARALIK KADEME SAYISINDAN
    Eskiden bar modlarinda aralik sabit 12.6 deg idi: 17 kademe 201.6 deg kapliyor, k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
    [foc_haptic.cpp]
2026-10-15 HS: mouseMoved eventtap kaldirildi -- ObjC olay nesnesi sizdiriyordu
    Onceki iki commit (surec acmayan sendLine + olay tabanli parlaklik) buyuk sizintiyi
    kesti ama yavas buyume surdu: footprint 56 MB (14.10 13:37) -> 177 MB (15.10 12:00),
    ~5 MB/saat, surec yeniden baslamadan.
    Kaynak `heap` ile bulundu (ObjC nesne sayimi -- RSS ile AYIRT EDILEMEZDI):
    10 dakikada CGEvent 9 -> 24.840
    HIDEvent 3 -> 74.373
    Bu nesneler ObjC tarafinda kaliyor, collectgarbage() SERBEST BIRAKMIYOR -- bu yuzden
    gcTimer de ise yaramiyordu. Dogrulama: mouseTap 150 sn durdurulunca artis
    626/75sn -> 11/150sn'ye dustu. Yani sizinti callback'in icinde ne yaptigimizla ilgili
    degil (orada zaten is yok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
2026-10-15 Konumlandirma tek yola indi: ortalama da hassas, 2.9 derece bosluk gitti
    IKI MEKANIZMA VARDI, BIRLESTIRILDI
    Ses/parlaklik hassas yoldan gidiyordu (Kdet 22 + integral, tolerans 0.05 deg, tam voltaj;
    olculen isabet 0.02-0.05 deg). Space/tabs ortalamasi ise Temmuz'dan kalma kaba yoldan:
    Kcenter=6, integral YOK, tolerans 0.05 rad (2.9 deg), 2.5V tavan, 700 ms zaman asimi.
    Iki mekanizma tutmanin gerekcesi yoktu. Artik hepsi hassas yolu kullaniyor.
    Olculdu: ortalama 169.3 yerine TAM 166.5'e oturuyor (midA), sapma sifir.
    Yan fayda: "merkeze tam varamayip her 5 saniyede bir tekrar tetiklenme" dongusu kokten
    imkansiz hale geldi -- her seferinde tam variyor.
    IPTAL OLCUTU DEGISTI: e*hiz -> fiziksel t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
2026-10-15 HS: konsol gecmisi 500 satirla sinirlandi + tekrar eden log'lar ayiklamaya bagli
    mouseTap sizintisi cozuldukten sonra kalan buyume konsoldu: 10 dk'da 320 satir
    (~1750/saat), hs.console.maxOutputHistory() varsayilani 100.000. Her satir
    NSCountableTextLocation/CFString nesnesi tutuyor -> 10 dk'da footprint 29 -> 45 MB.
    En sik satir "[knob] spaces girdi -> SP n i": pushState'ten geliyor ve 10 sn'lik SYNC
    el sikismasiyla tetikleniyor, deger DEGISMESE DE basiliyordu.
    (onVol/onSpace/onBright/onTabs zaten sadece degisimde basiyor, onlara dokunulmadi --
    gercek olaylar gorunur kalsin.)
    Degisiklik:
    - hs.console.maxOutputHistory(500) (dosyanin basinda, gerekcesiyle)
    - M.debug bayragi + dbg() yardimc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
2026-10-20 Ayri haptik ayar tezgahi (env:haptictune) + bar modlarinda Kdet 22 -> 15
    AYRI TEST FIRMWARE'I
    Centik aralagi/sertligi/sonumu denemek icin uretim firmware'ine A/B iskelesi
    eklemistim; kullanici hakli olarak "yerlesik firmware uzerinden gitmeyelim" dedi.
    Iskele geri alindi, yerine ayri bir hedef: src/haptic_tune.cpp + env:haptictune.
    HID YOK - Mac'e hicbir sey gondermez (tus/ses/masaustu)
    MOD YOK - tek bir sonsuz centik gridi; duvar, ortalama, deploy yok
    HS YOK - Hammerspoon ile konusmaz
    Butonlar (PCF8574): centik sayisi -/+, Kdet -/+, sonum -/+, A/B gecis, slota kopyala.
    Ekranda surekli: slot, centik sayisi, aralik (deg), K, B ve TEPE KUVVET (V) -- kor test
    yapmamak icin. Seri kom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
2026-11-06 Lisans eklendi: kod MIT, dokuman ve 3B modeller CC BY 4.0
    MT6701 SSI surucusu simplefoc/Arduino-FOC-drivers'tan degistirilmeden
    alinmis; MIT atif basligi eklendi (c) 2021 Richard Unger. Kod govdesi
    ust kaynakla birebir ayni, diff ile dogrulandi -- sadece baslik eklendi.
    Koken tartismasi docs/tartisma.md olarak depoya girdi.
